NicoGomez4262/control-carga-evse/docs/referencias/F4_autoprogramacion_profesor.jpg

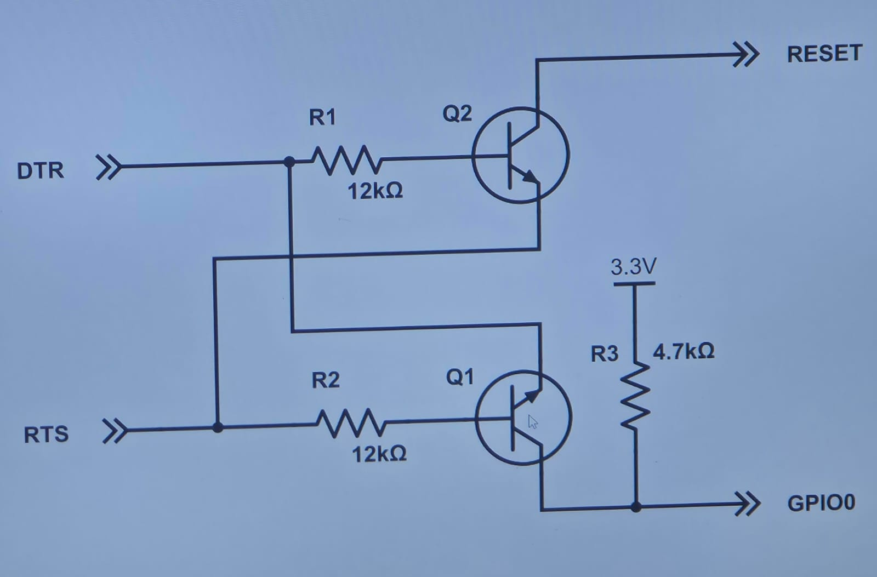
docs/referencias/F4_autoprogramacion_profesor.jpg
