NicoGomez4262/control-carga-evse/docs/revisiones/03_MEDICION_despues_scripts_F4.png

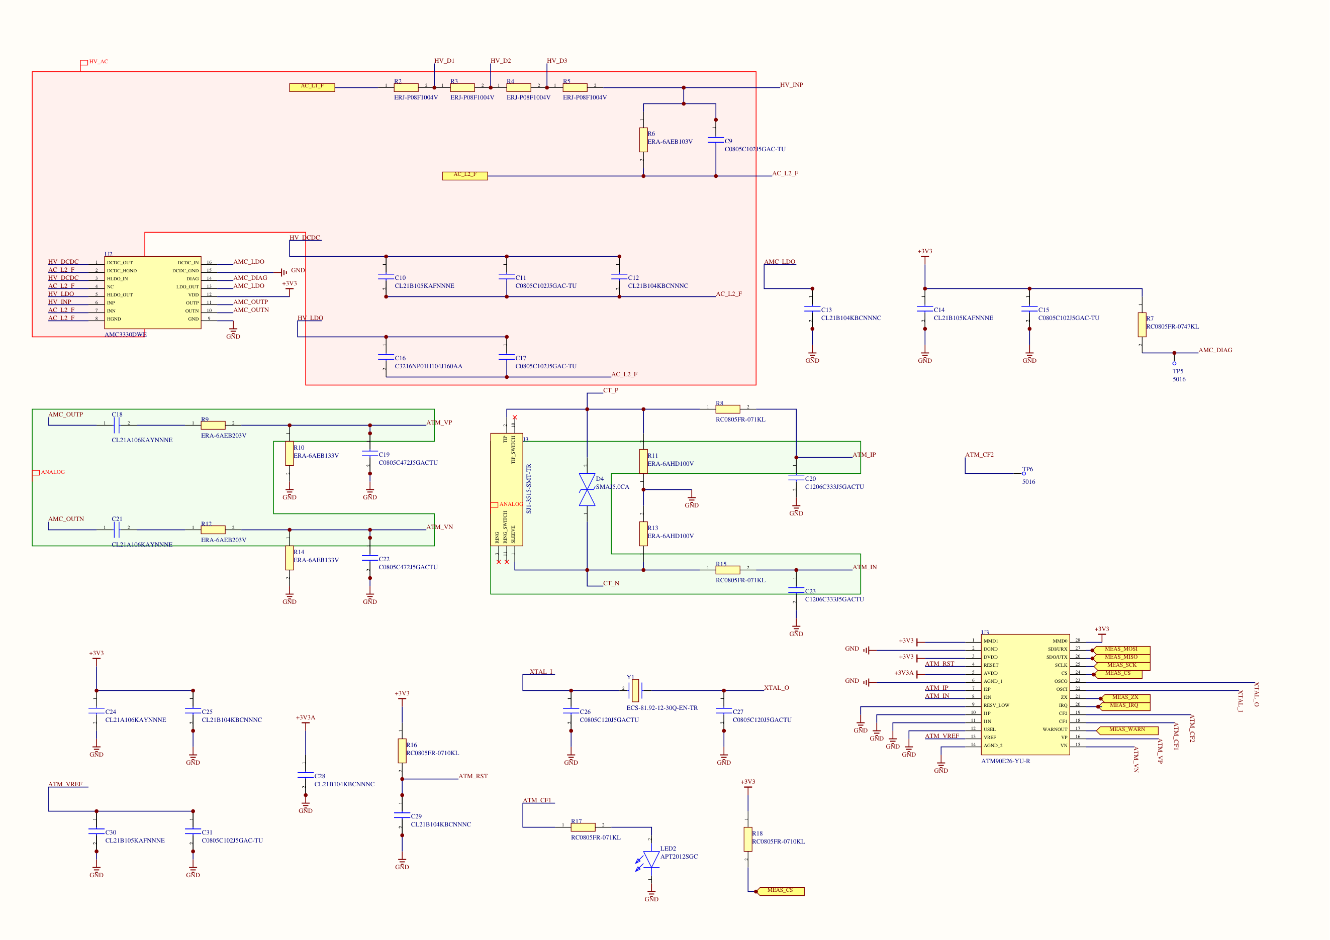
docs/revisiones/03_MEDICION_despues_scripts_F4.png
