NicoGomez4262/control-carga-evse/docs/revisiones/bloque_serigrafia_f9.png

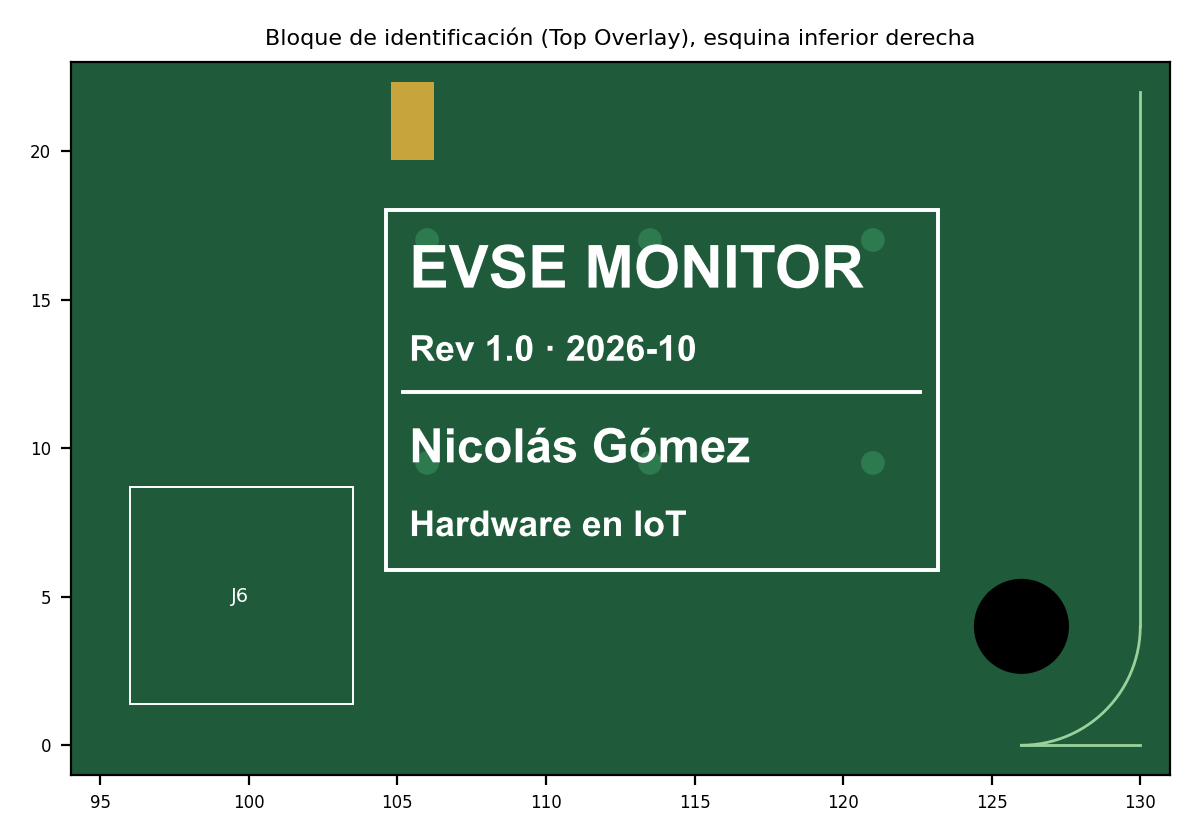
docs/revisiones/bloque_serigrafia_f9.png
