NicoGomez4262/control-carga-evse/docs/revisiones/F8_prerruteo.png

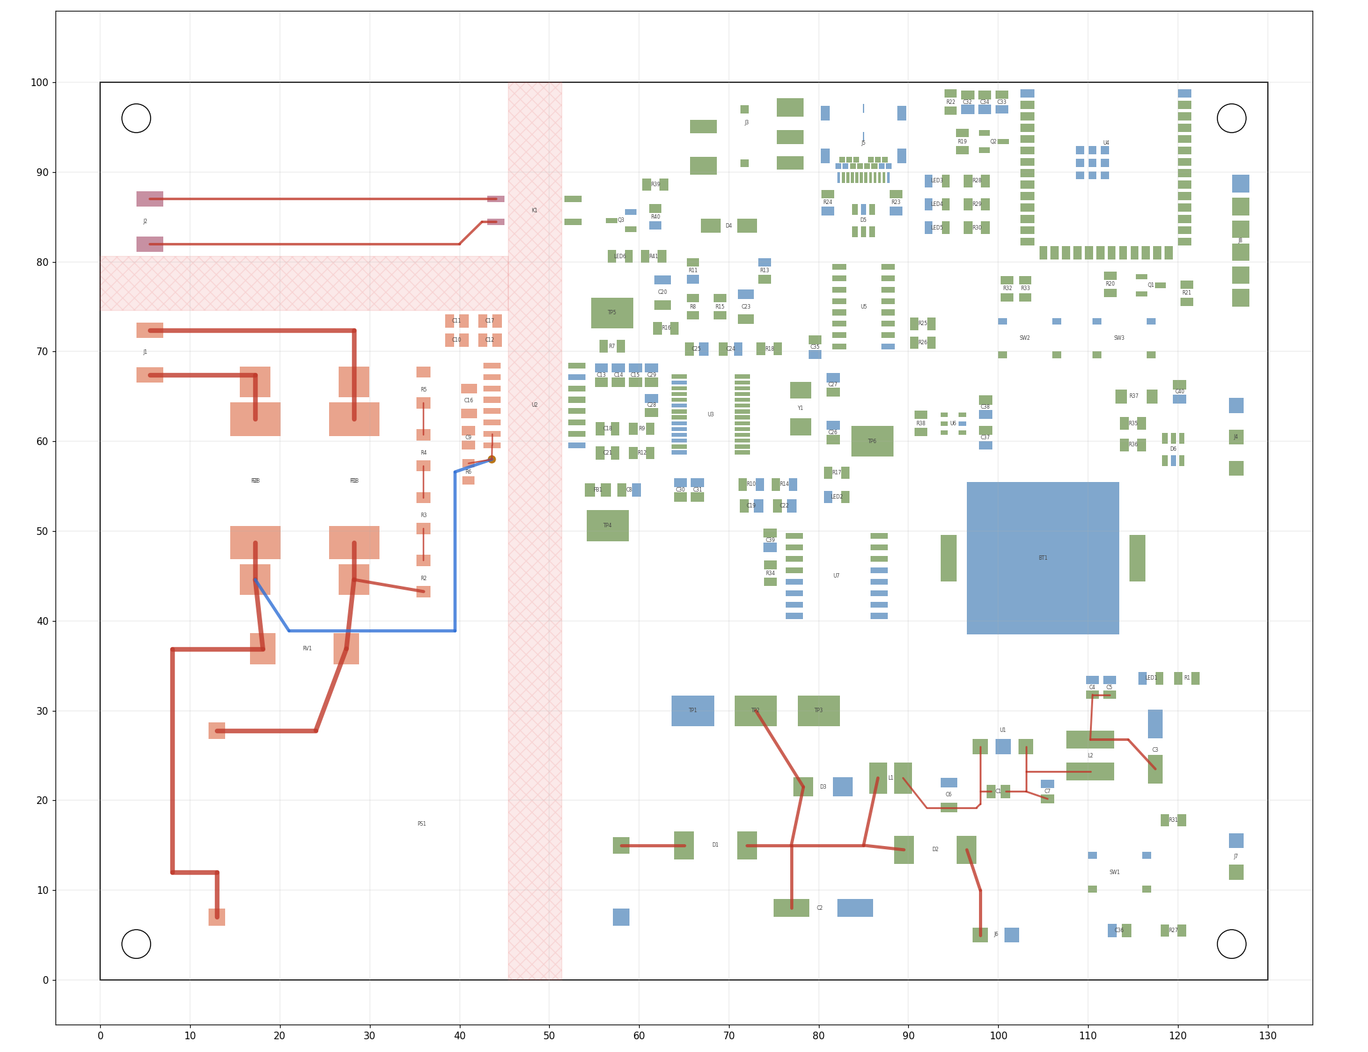
docs/revisiones/F8_prerruteo.png
