NicoGomez4262/control-carga-evse/docs/revisiones/F8_ratsnest.png

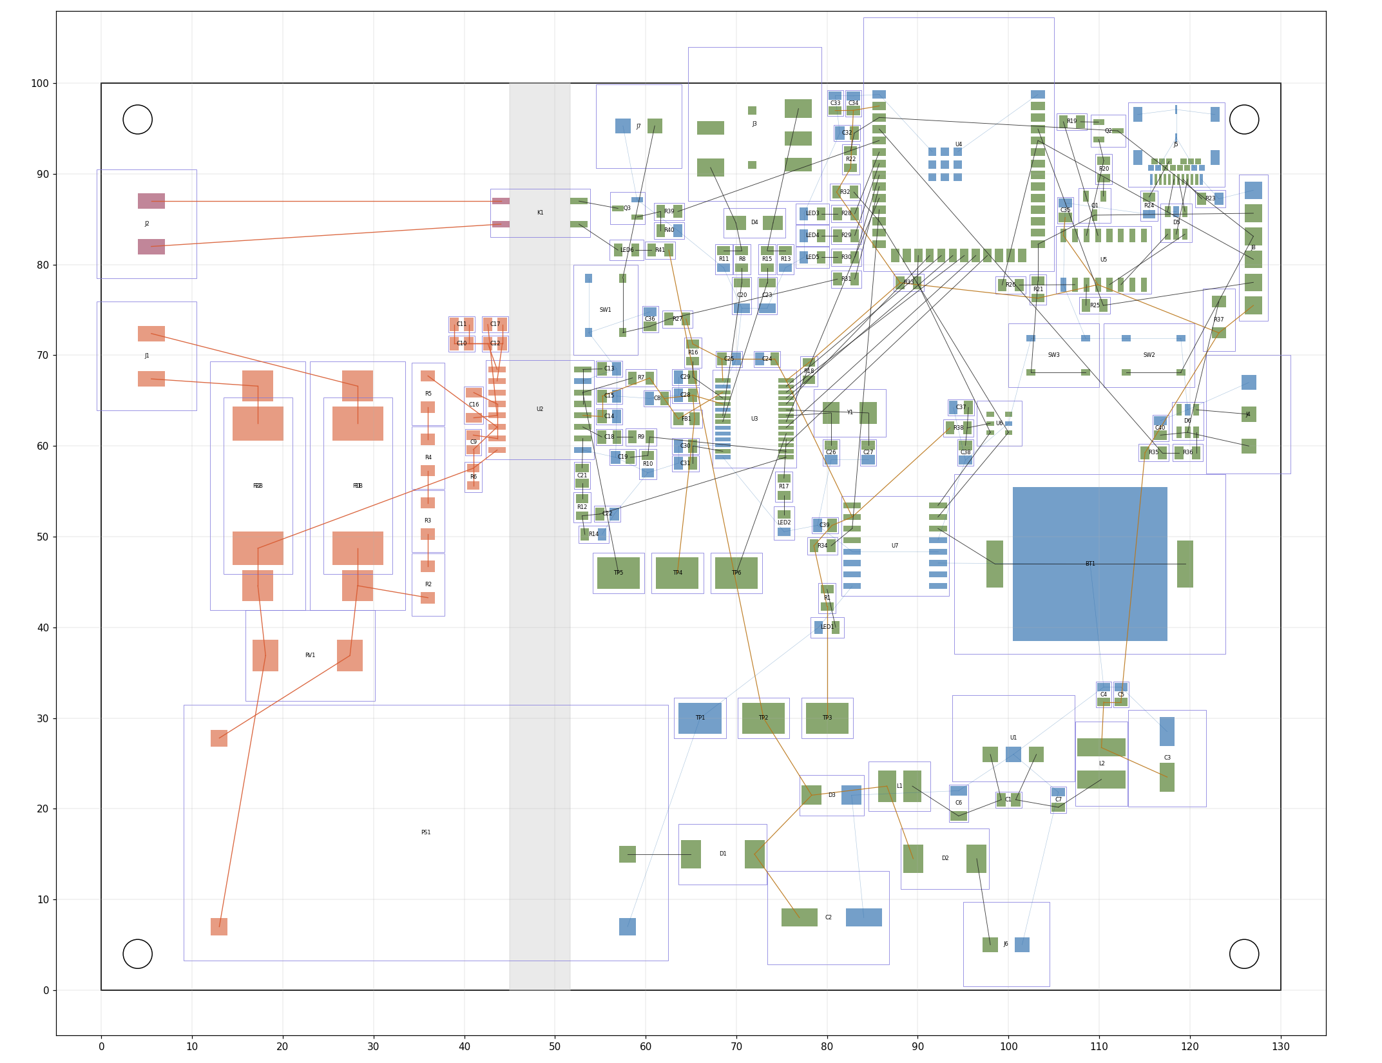
docs/revisiones/F8_ratsnest.png
