NicoGomez4262/control-carga-evse/docs/revisiones/F8_ruteo_completado.png

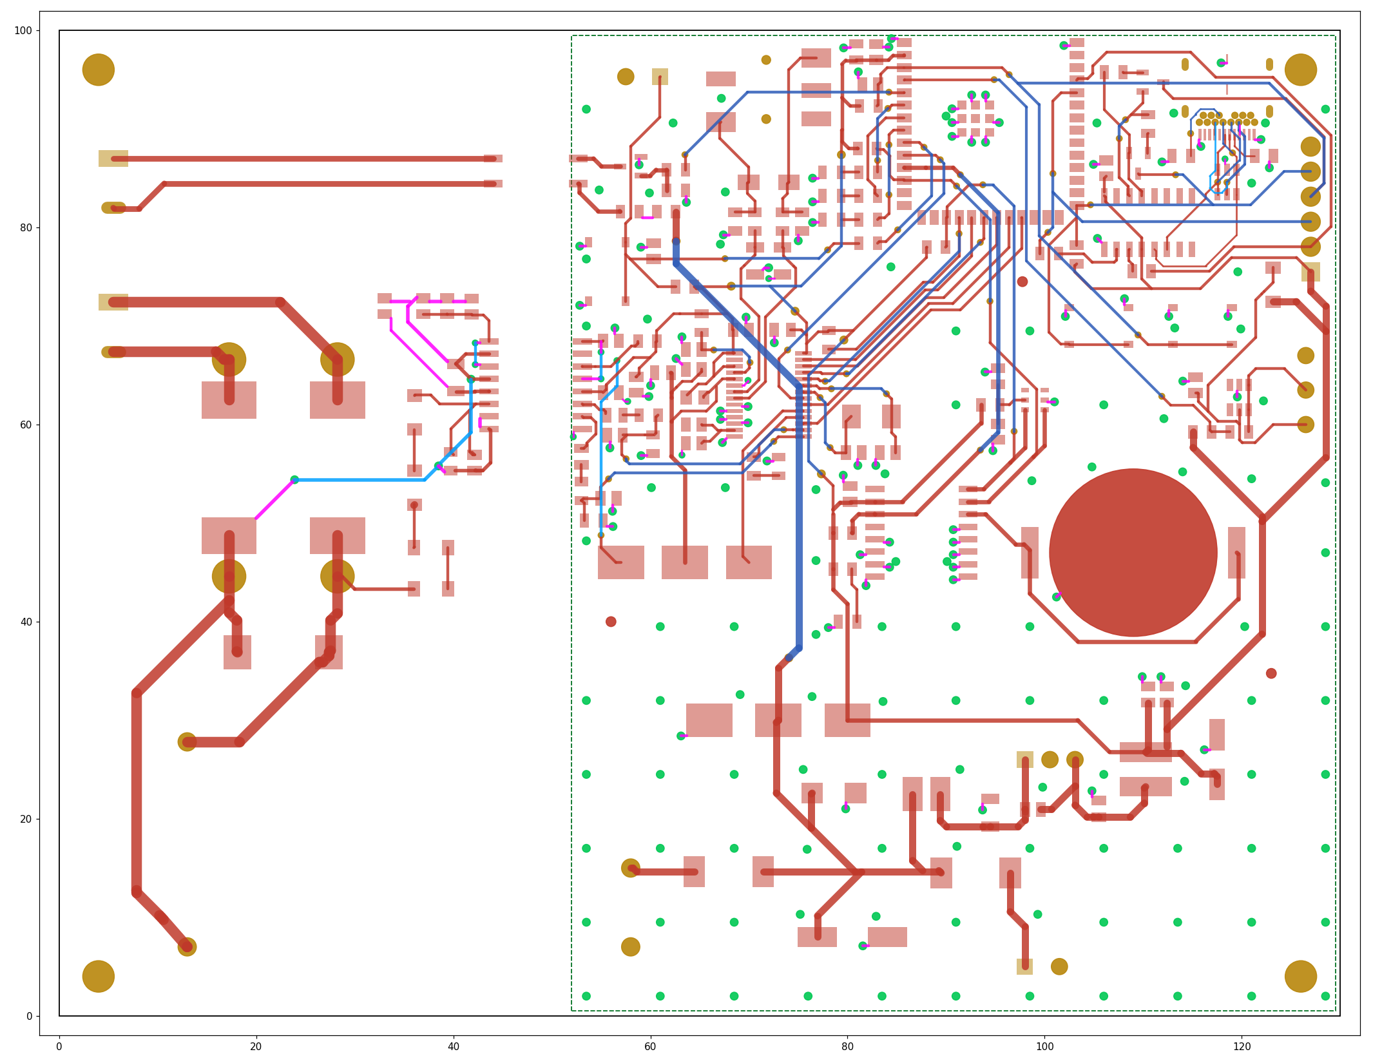
docs/revisiones/F8_ruteo_completado.png
