NicoGomez4262/control-carga-evse/docs/revisiones/F8_ruteo_revision.png

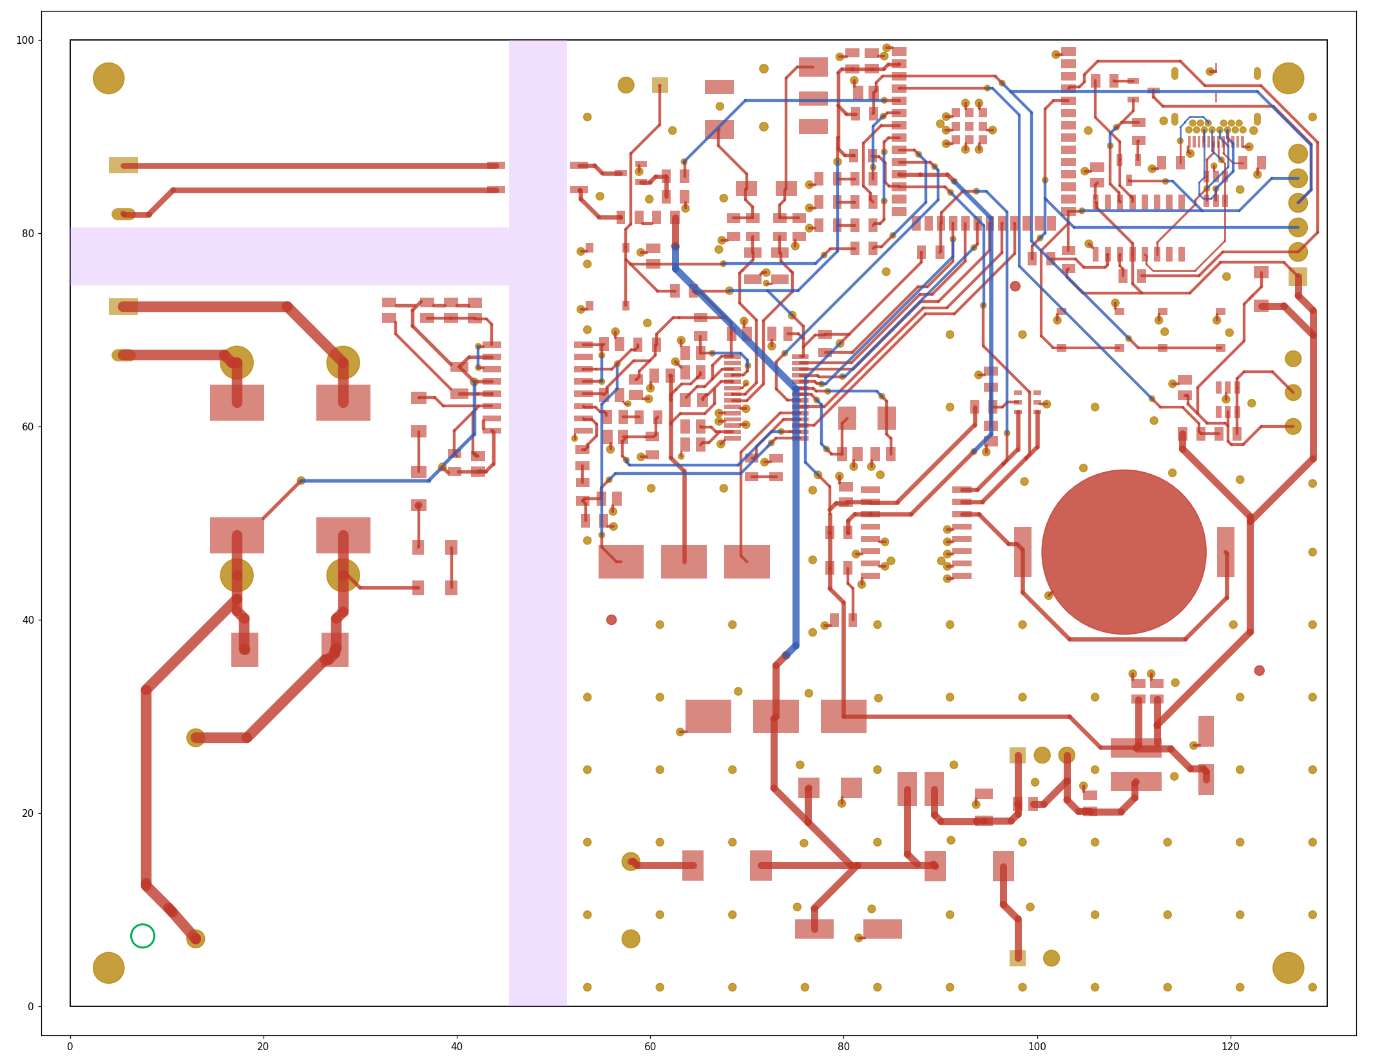
docs/revisiones/F8_ruteo_revision.png
