NicoGomez4262/control-carga-evse/docs/revisiones/F8_serigrafia.png

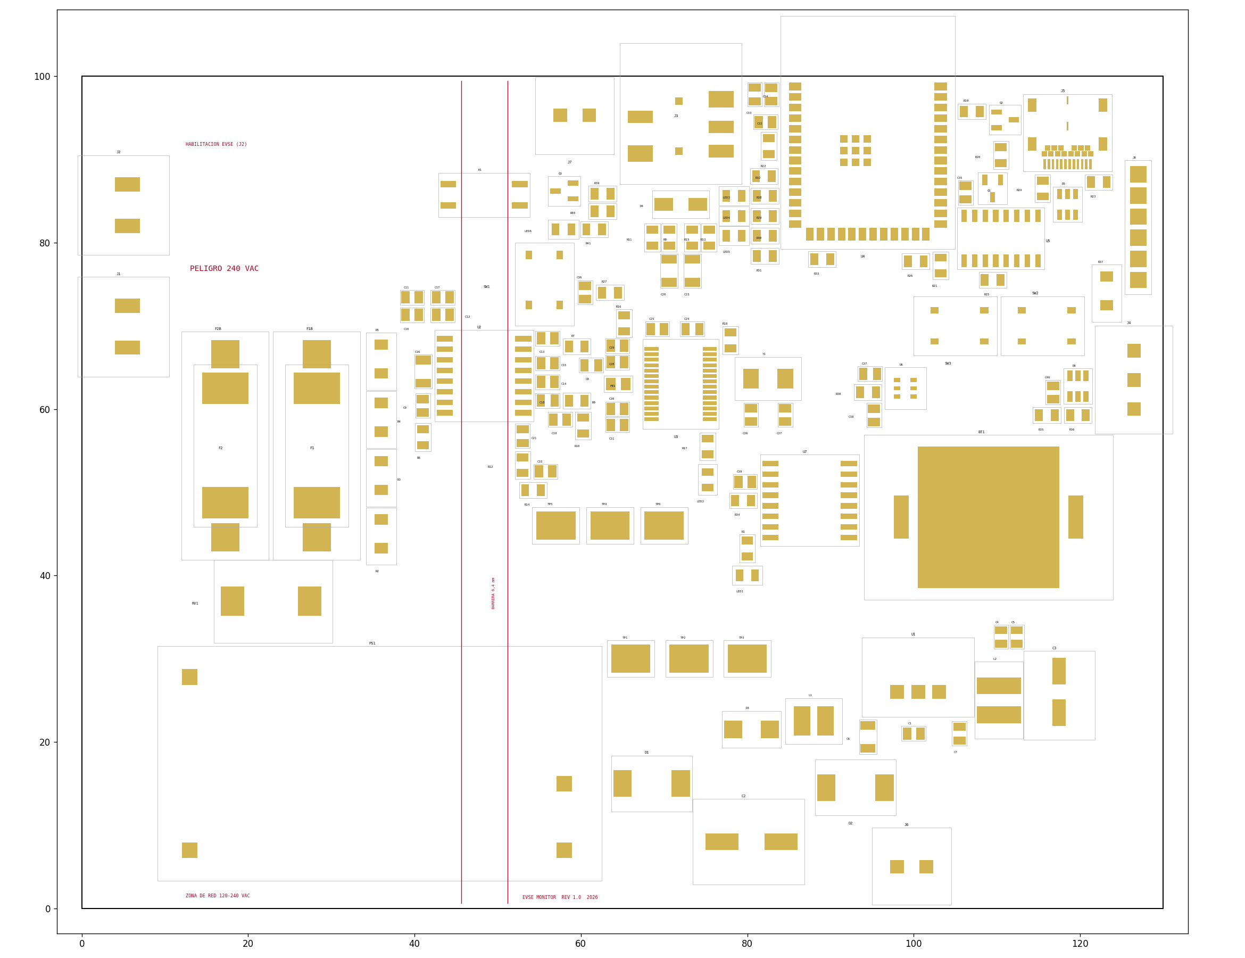
docs/revisiones/F8_serigrafia.png
