NicoGomez4262/control-carga-evse/docs/revisiones/F8_ubicacion.png

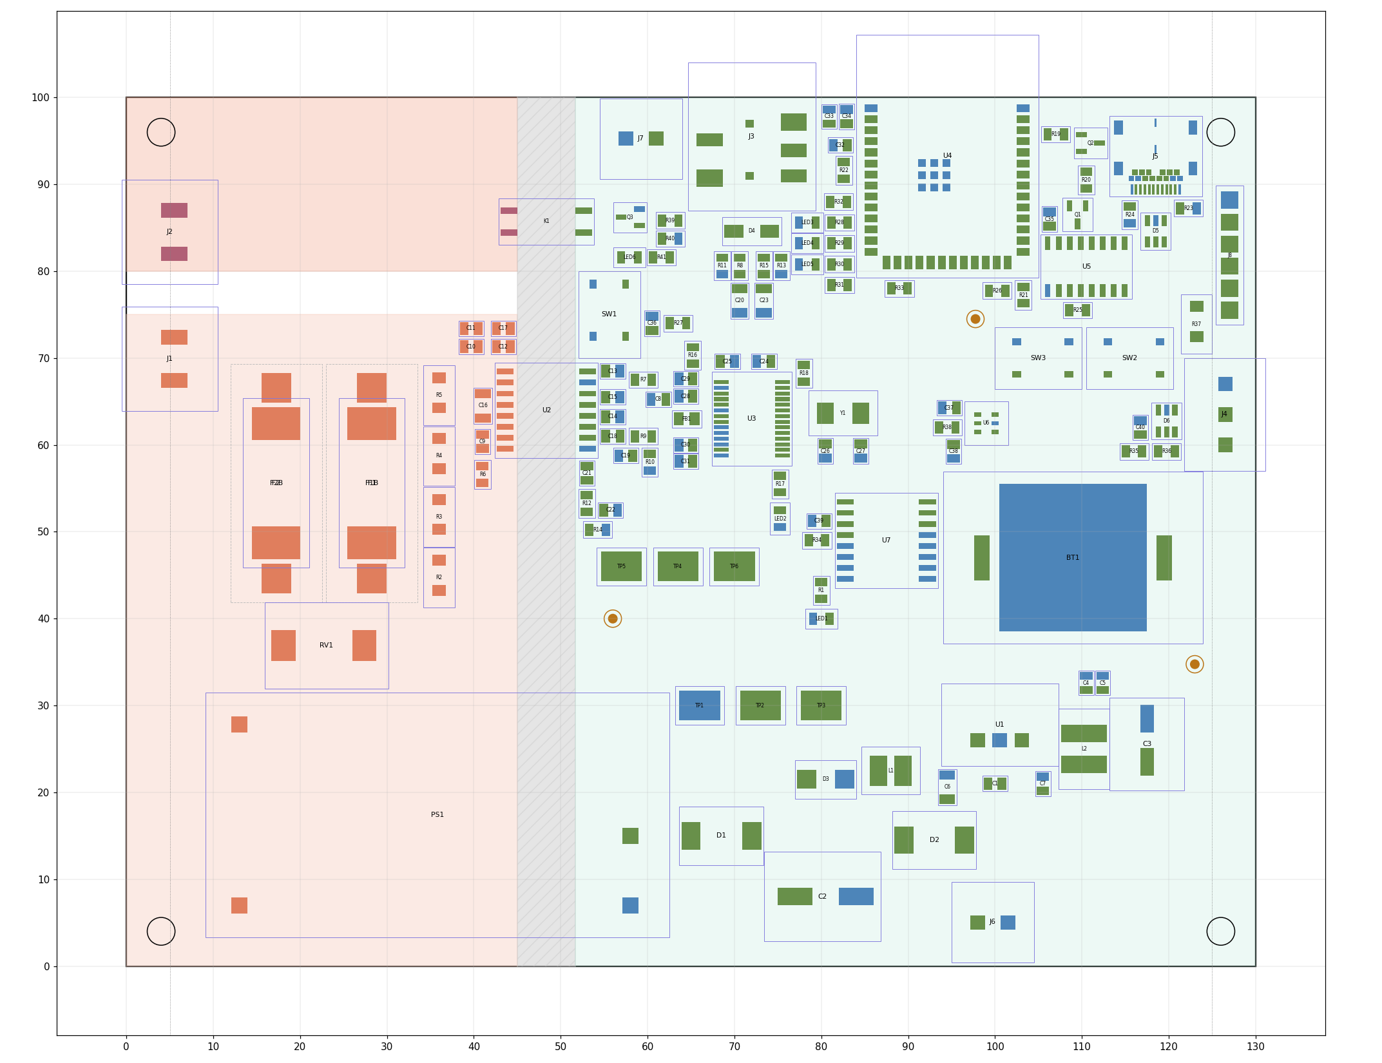
docs/revisiones/F8_ubicacion.png
