NicoGomez4262/control-carga-evse/docs/revisiones/gerber/bottom_cobre.png

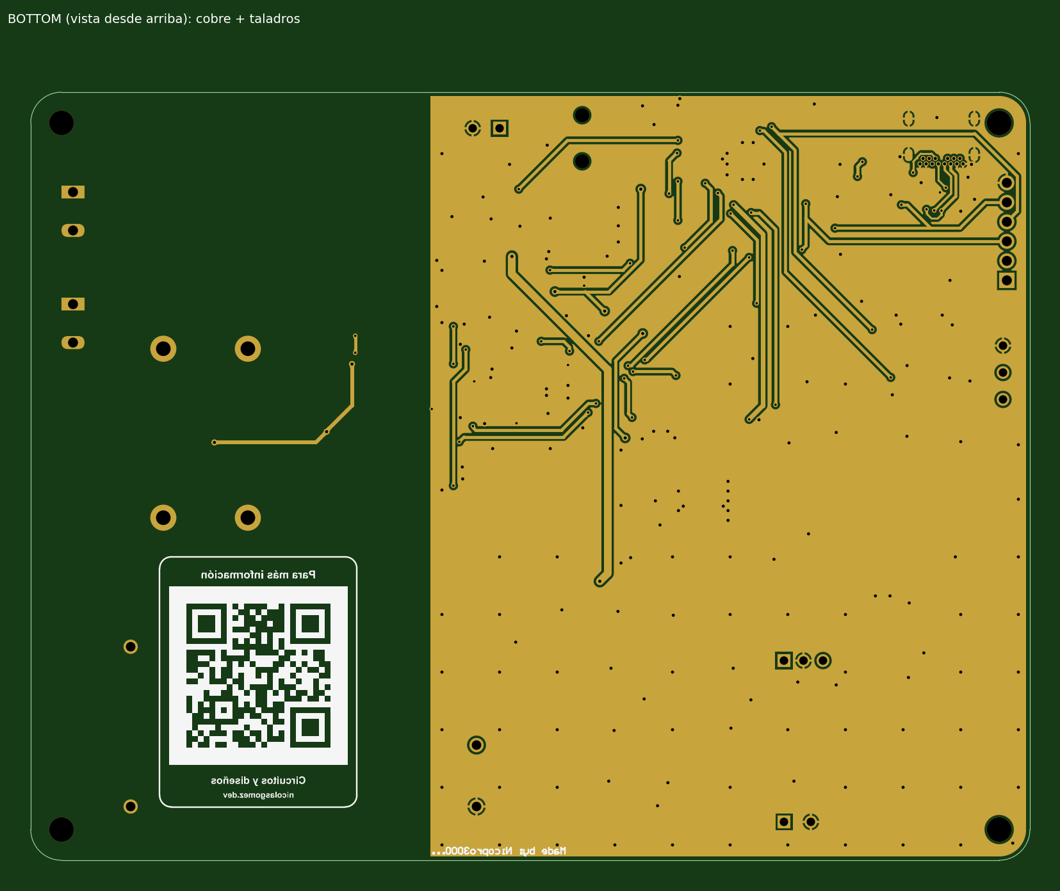
docs/revisiones/gerber/bottom_cobre.png
