NicoGomez4262/control-carga-evse/docs/revisiones/gerber/GBL.png

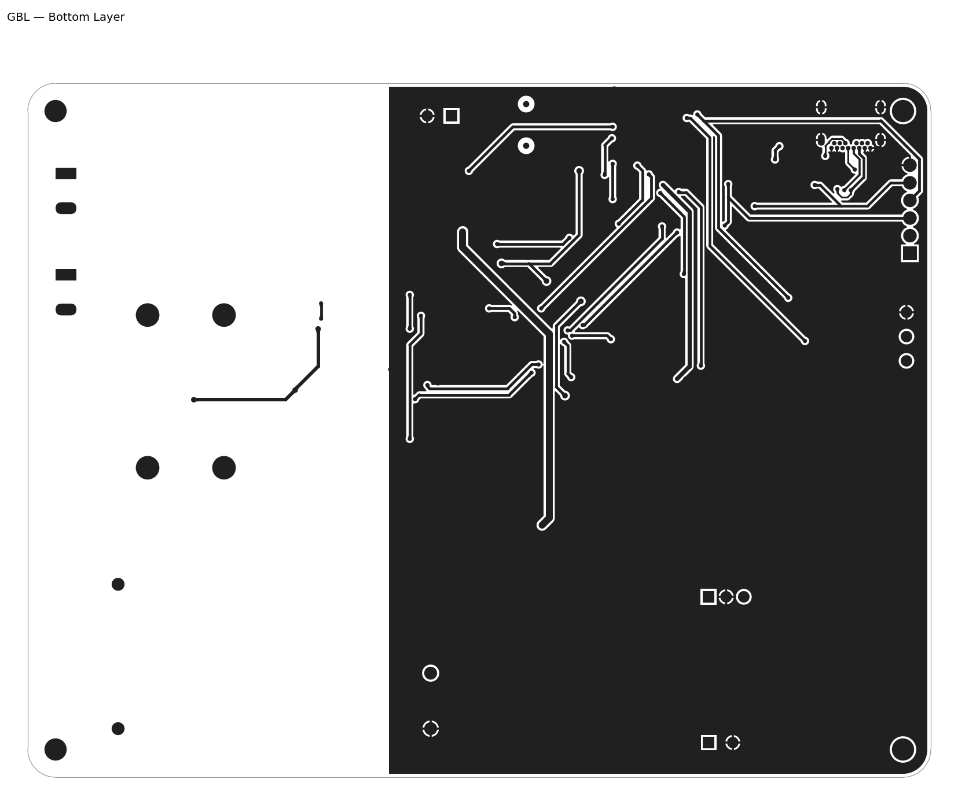
docs/revisiones/gerber/GBL.png
