NicoGomez4262/control-carga-evse/docs/revisiones/gerber/GBO.png

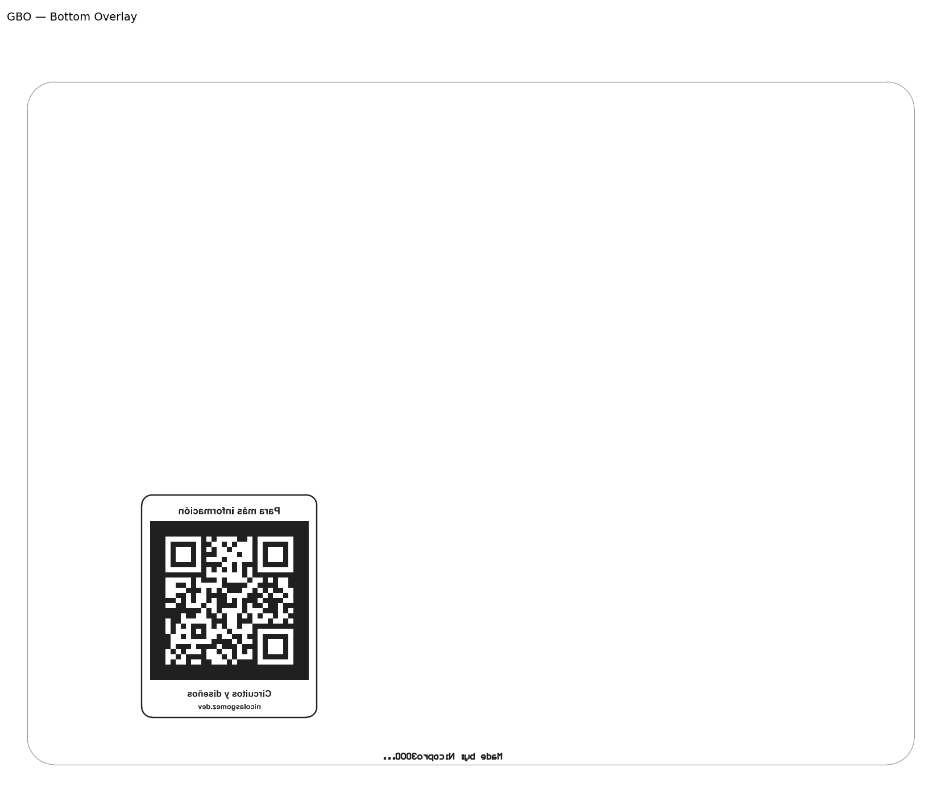
docs/revisiones/gerber/GBO.png
