NicoGomez4262/control-carga-evse/docs/revisiones/gerber/GTL.png

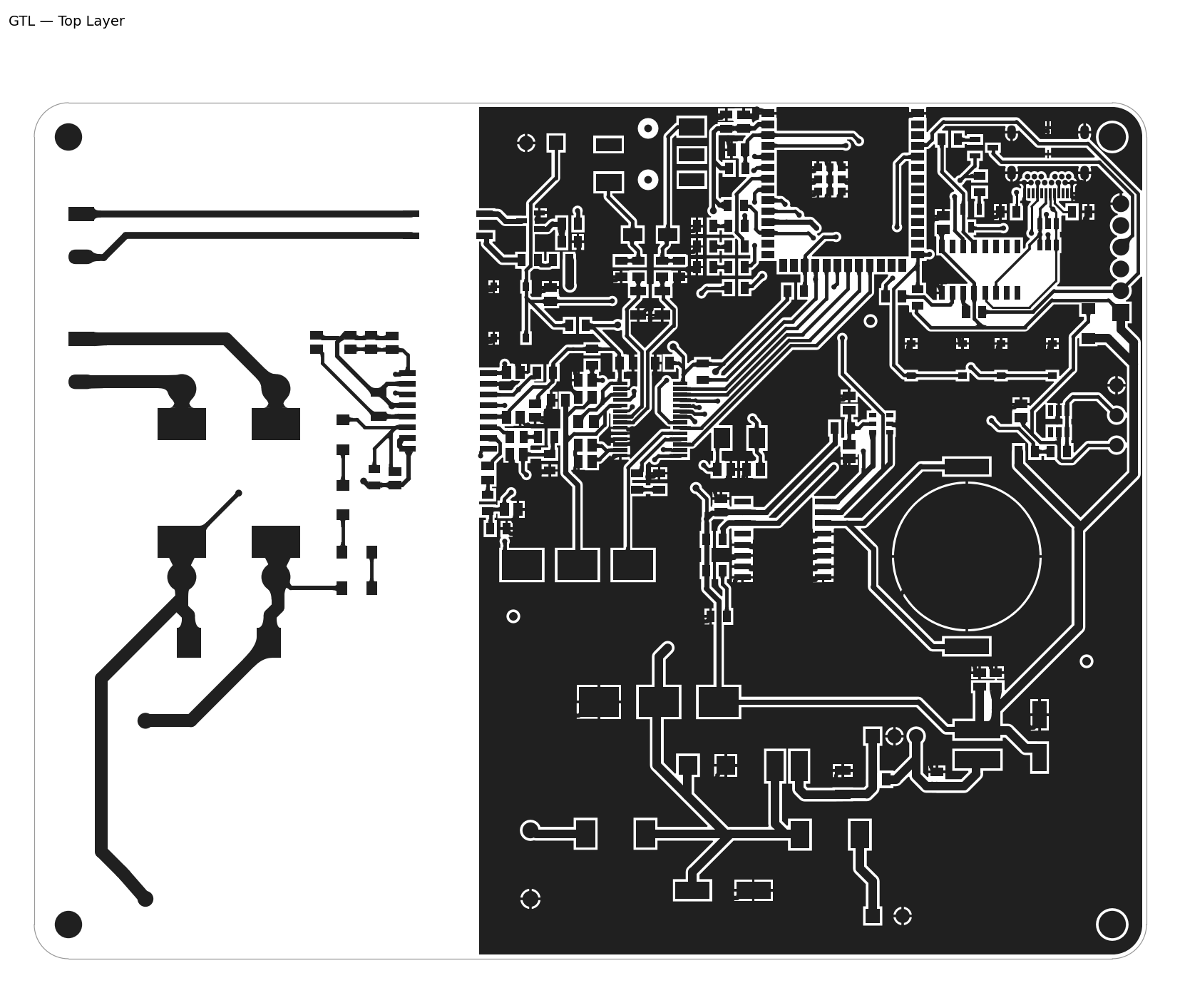
docs/revisiones/gerber/GTL.png
