NicoGomez4262/control-carga-evse/docs/revisiones/gerber/GTO.png

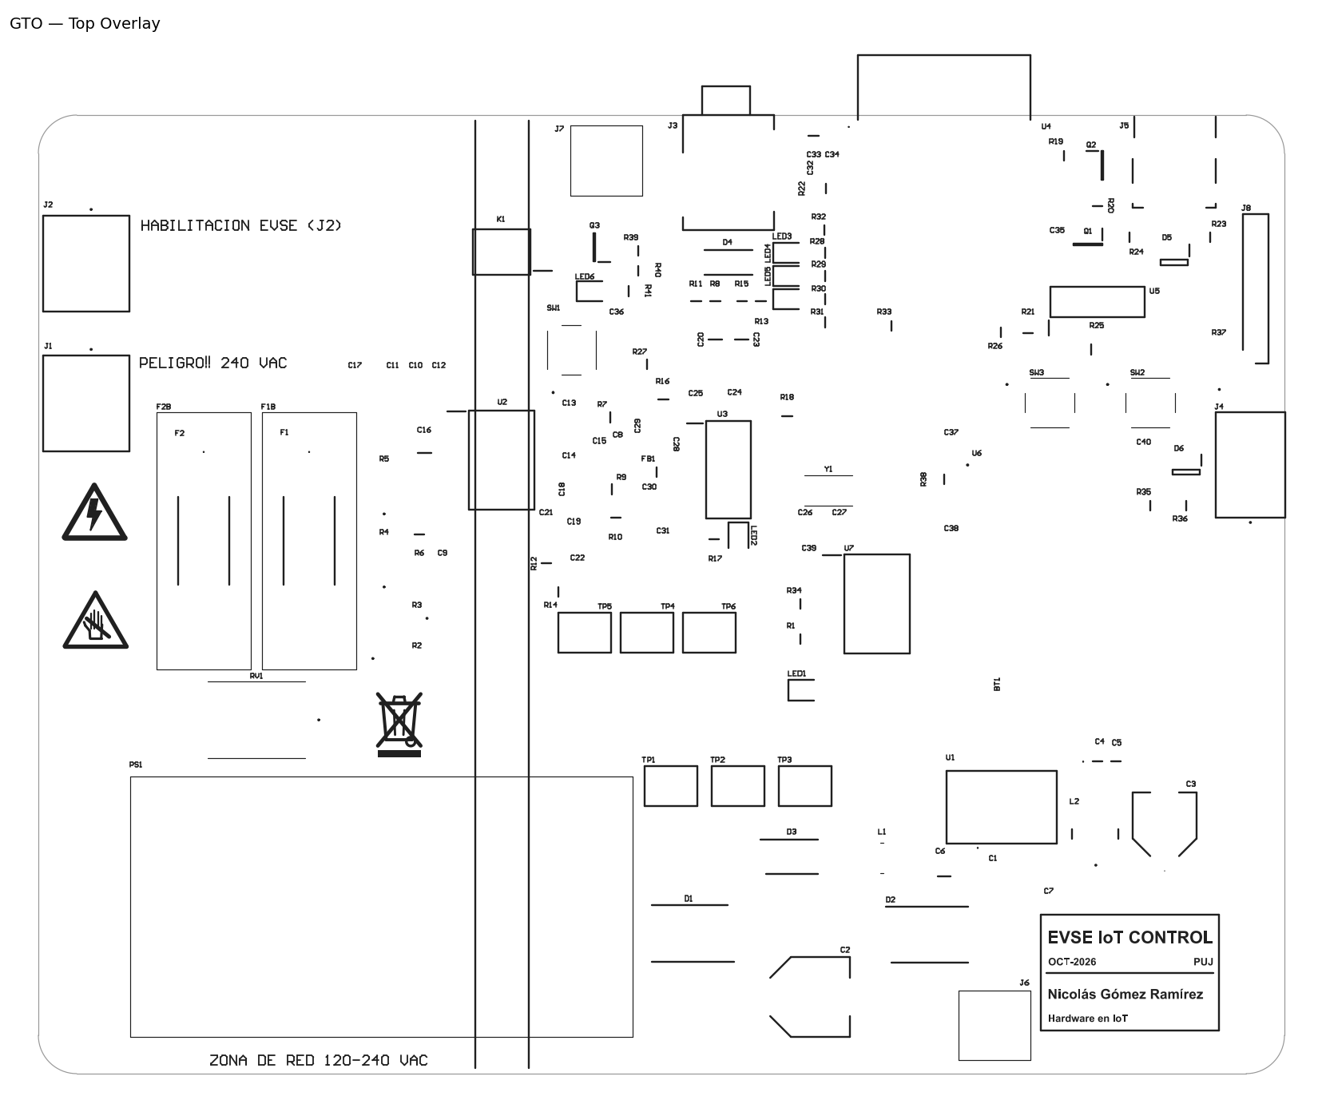
docs/revisiones/gerber/GTO.png
