NicoGomez4262/control-carga-evse/docs/revisiones/gerber/top_cobre_serigrafia.png

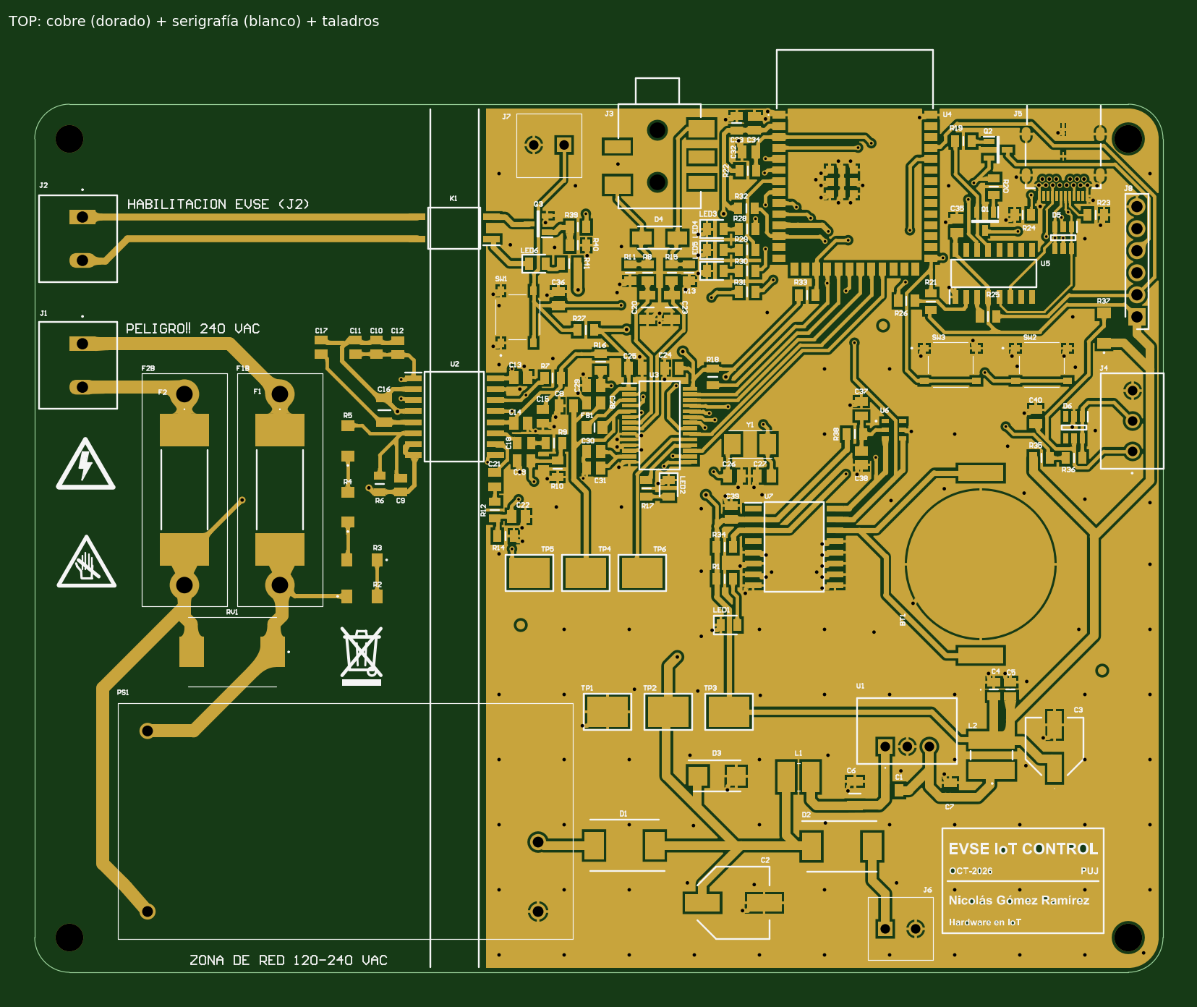
docs/revisiones/gerber/top_cobre_serigrafia.png
