NicoGomez4262/control-carga-evse/docs/revisiones/gerber/top_mascara.png

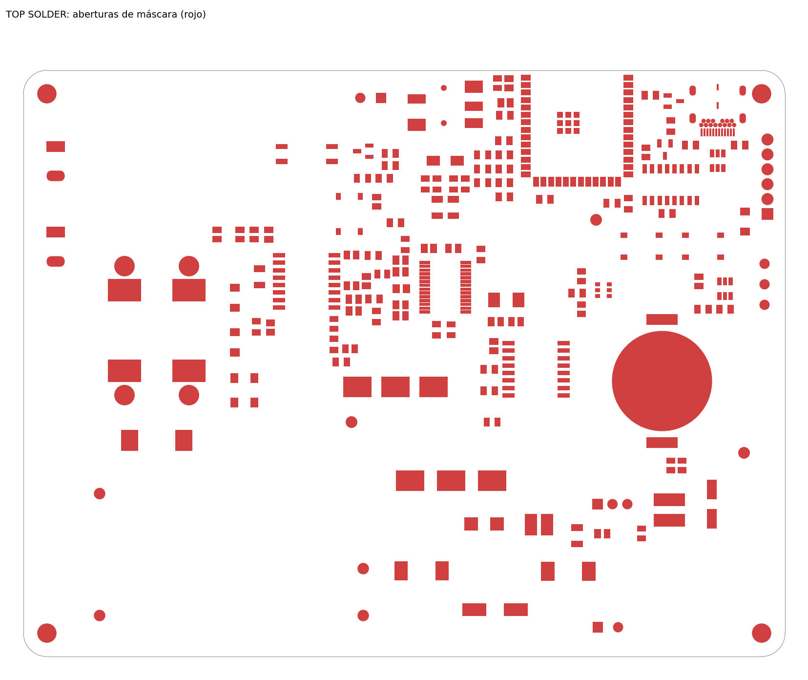
docs/revisiones/gerber/top_mascara.png
