NicoGomez4262/control-carga-evse/docs/revisiones/gerber/top_pasta.png

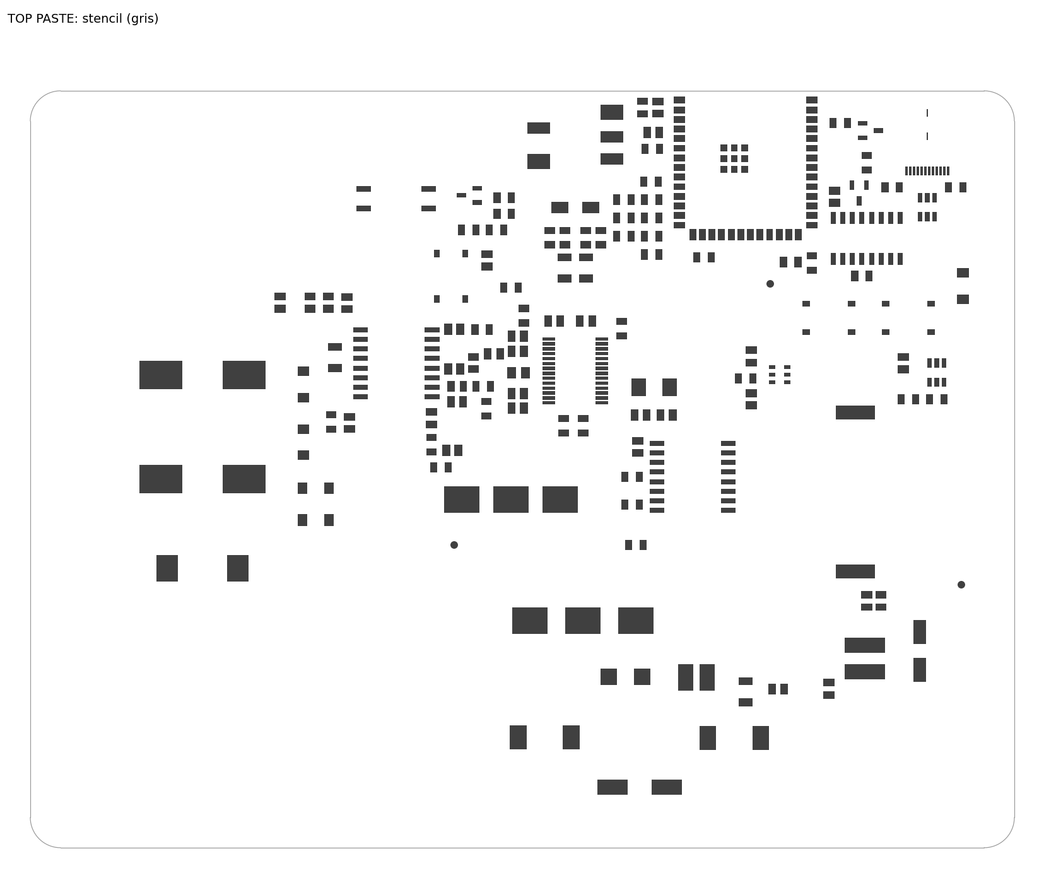
docs/revisiones/gerber/top_pasta.png
