NicoGomez4262/control-carga-evse/docs/revisiones/marcas_f9_bottom.png

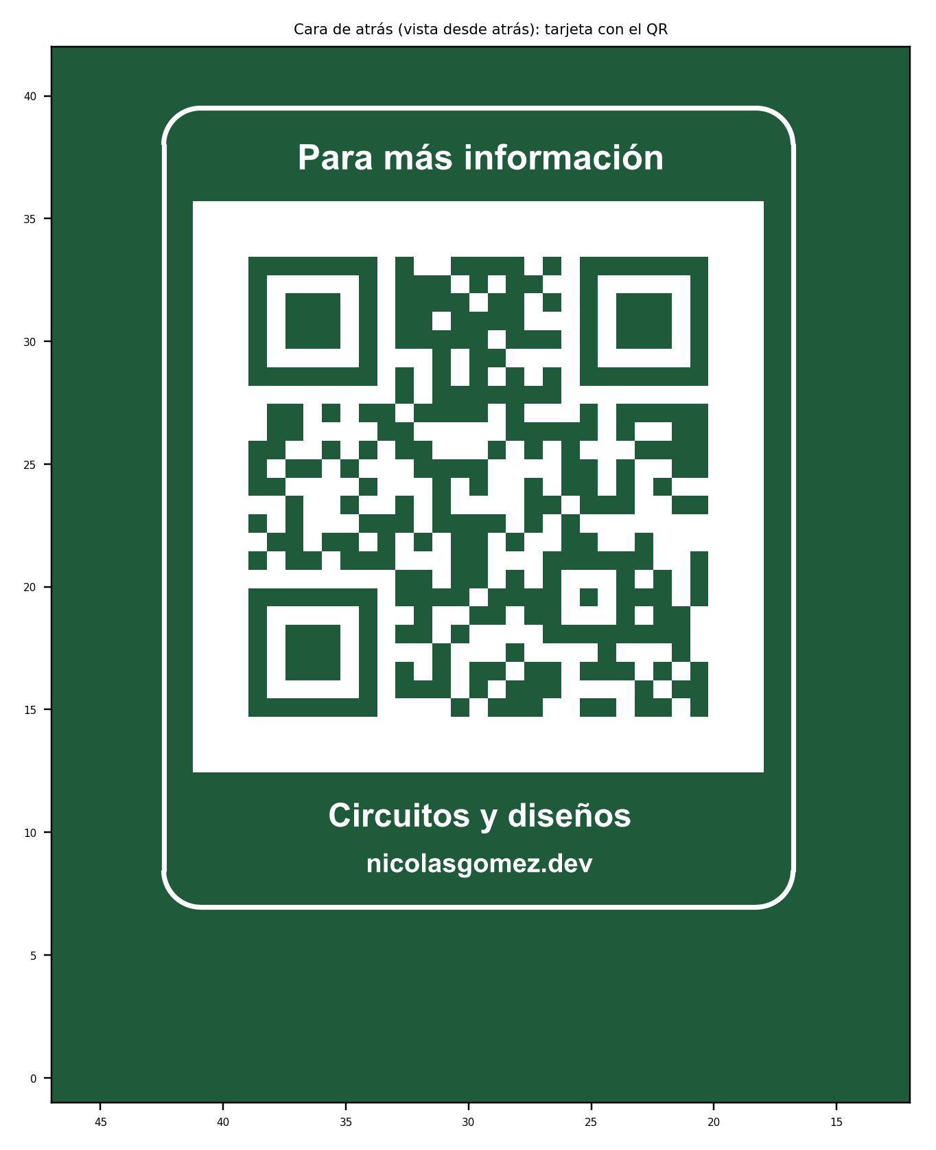
docs/revisiones/marcas_f9_bottom.png
