NicoGomez4262/control-carga-evse/docs/revisiones/marcas_f9_top.png

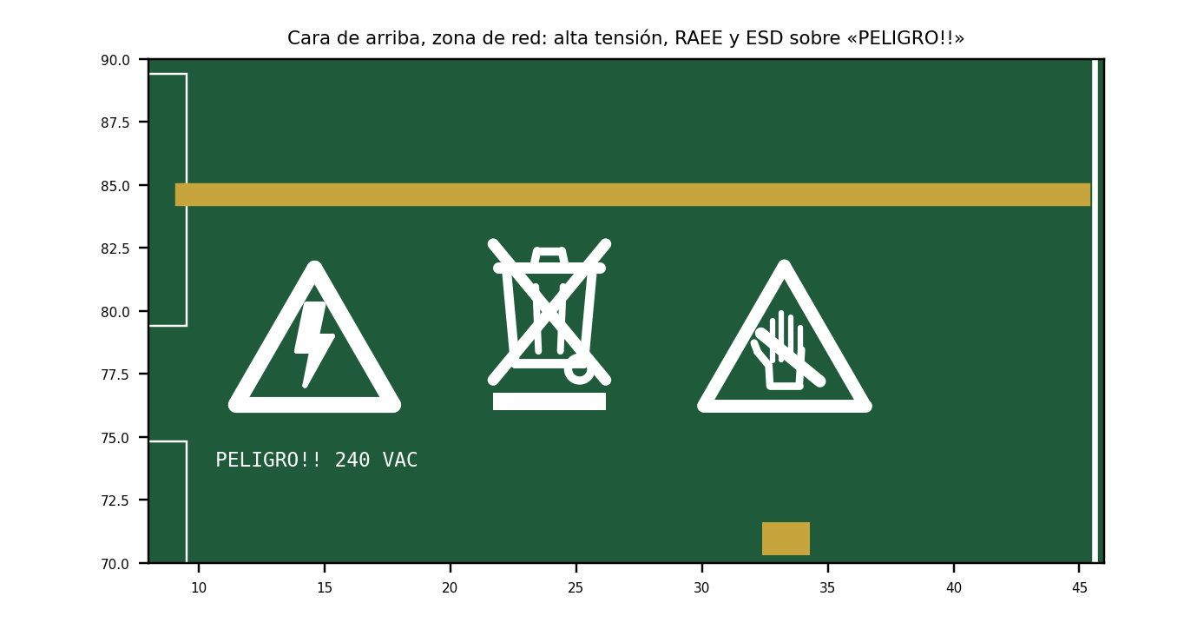
docs/revisiones/marcas_f9_top.png
