NicoGomez4262/control-carga-evse/docs/fabricacion/BOM_JLC.csv

Comment | Designator | Footprint | JLCPCB Part #
BAT-HLD-001 | BT1 | BATHLD001 | C7501066
C0805C102J5GACTU | C1,C9,C11,C15,C17,C31 | CAPC2012X88N | C2167084
EEE-FK1V101P | C2 | EEHZT1E331UP | C128462
EEE-FK1C101P | C3 | EEE1AA101SP | C128532
CL21A226MAQNNNE | C4,C5,C33 | CAPC2012X140N | C45783
CL31B106KBHNNNE | C6 | CAPC3216X180N | C89632
CL21A106KAYNNNE | C7,C8,C18,C21,C24,C37 | CAPC2012X145N | C15850
CL21B105KBFNNNE | C10,C14,C30,C32 | CAPC2012X88N | C28323
CC0805KRX7R9BB104 | C12,C13,C25,C28,C29,C34,C35,C36,C38,C39,C40 | CAPC2012X88N | C49678
GRM31C5C1H104JA01L | C16 | CAPC3216X180N | C97946
C0805C472J5GACTU | C19,C22 | CAPC2012X88N | C2170898
GRM3195C1H333JA01D | C20,C23 | CAPC3216X180N | C97930
C0805C120J5GACTU | C26,C27 | CAPC2012X88N | C2168859
SS34-E3/57T | D1,D2 | DIOM7959X262N | C13354
SMBJ15A | D3 | DIOM5436X244N | C83846
SMAJ5.0CA | D4 | DIONM5026X229N | C83324
USBLC6-2SC6 | D5,D6 | SOT95P280X145-6N | C7519
3403.0274.11 | F1,F2 | 3403027423 | C6384960
BLM21PG221SN1D | FB1 | BEADC2012X105N | C85840
XY301V-A-5.0-2P | J1,J2 | TB001-500-02BE | C557651
SJ1-3515-SMT-TR | J3 | SJ13515SMTTR | C22359767
1751251 | J4 | 1751251 | C91152
632723300011 | J5 | 632723300011 | C2830802
1751248 | J6,J7 | 1751248 | C89122
61300611121 | J8 | HDRV6W79P0X254_1X6_1524X254X894P | C5444523
LQH43NH120J03L | L1 | RLS126 | C3224514
SRR4028-2R2Y | L2 | SRR4028 | C2041777
APT2012SGC | LED1,LED2,LED3,LED4 | LEDC2012X85N | C5353439
APT2012SURCK | LED5 | LEDC2012X85N | C5875730
KT-0805Y | LED6 | LEDC2012X85N | C2296
IRM-20-12 | PS1 | IRM2012 | C5278499
MMBT3904 | Q1,Q2 | SOT96P237X111-3N | C20526
AO3400A | Q3 | SOT96P237X111-3N | C20917
0805W8F1001T5E | R1,R8,R15,R17,R25,R26,R28,R29,R30,R31,R39,R41 | RESC2012X60N | C17513
ERJ-P08F1004V | R2,R3,R4,R5 | ERJP08_(1206) | C41369755
ERA-6AEB103V | R6 | RESC2012X60N | C191101
0805W8F4702T5E | R7 | RESC2012X60N | C17713
ERA-6AEB203V | R9,R12 | RESC2012X60N | C473304
ERA-6AEB133V | R10,R14 | RESC2012X60N | C445658
RT0805BRD0710RL | R11,R13 | RESC2012X60N | C865142
0805W8F1002T5E | R16,R18,R22,R27,R34,R40 | RESC2012X60N | C17414
0805W8F1202T5E | R19,R20 | RESC2012X60N | C17444
0805W8F4701T5E | R21,R32,R33,R35 | RESC2012X60N | C17673
0805W8F5101T5E | R23,R24 | RESC2012X60N | C27834
0805W8F1000T5E | R36 | RESC2012X60N | C17408
RC1206FR-0768RL | R37 | ERJP08_(1206) | C137238
0805W8F3300T5E | R38 | RESC2012X60N | C17630
RL4032P471KJ | RV1 | CU4032 | C2935514
TS-1187A-B-A-B | SW1 | TS1187ABAB | C318884
RH-5016 | TP1,TP2,TP3,TP4,TP5,TP6 | KEYSTONE-5016_V | C5199799
AMC3330DWER | U2 | SOIC127P1030X265-16N | C2999368
ATM90E26-YU-R | U3 | SOP65P778X199-28N | C616398
ESP32-S3-WROOM-1-N16R2 | U4 | ESP32S3WROOM1N16R2 | C2913205
CH340C | U5 | SOIC127P600X175-16N | C84681
AHT20 | U6 | AHT20 | C2757850
DS3231SN#T&R | U7 | SOIC127P1030X265-16N | C9866
ECS-81.92-12-30Q-EN-TR | Y1 | ECS81921230QENTR | C2450755
AQY214EHAX | K1 | SOP254P962X315-4N | C371971
