NicoGomez4262/control-carga-evse/docs/revisiones/F1_TOP.pdf

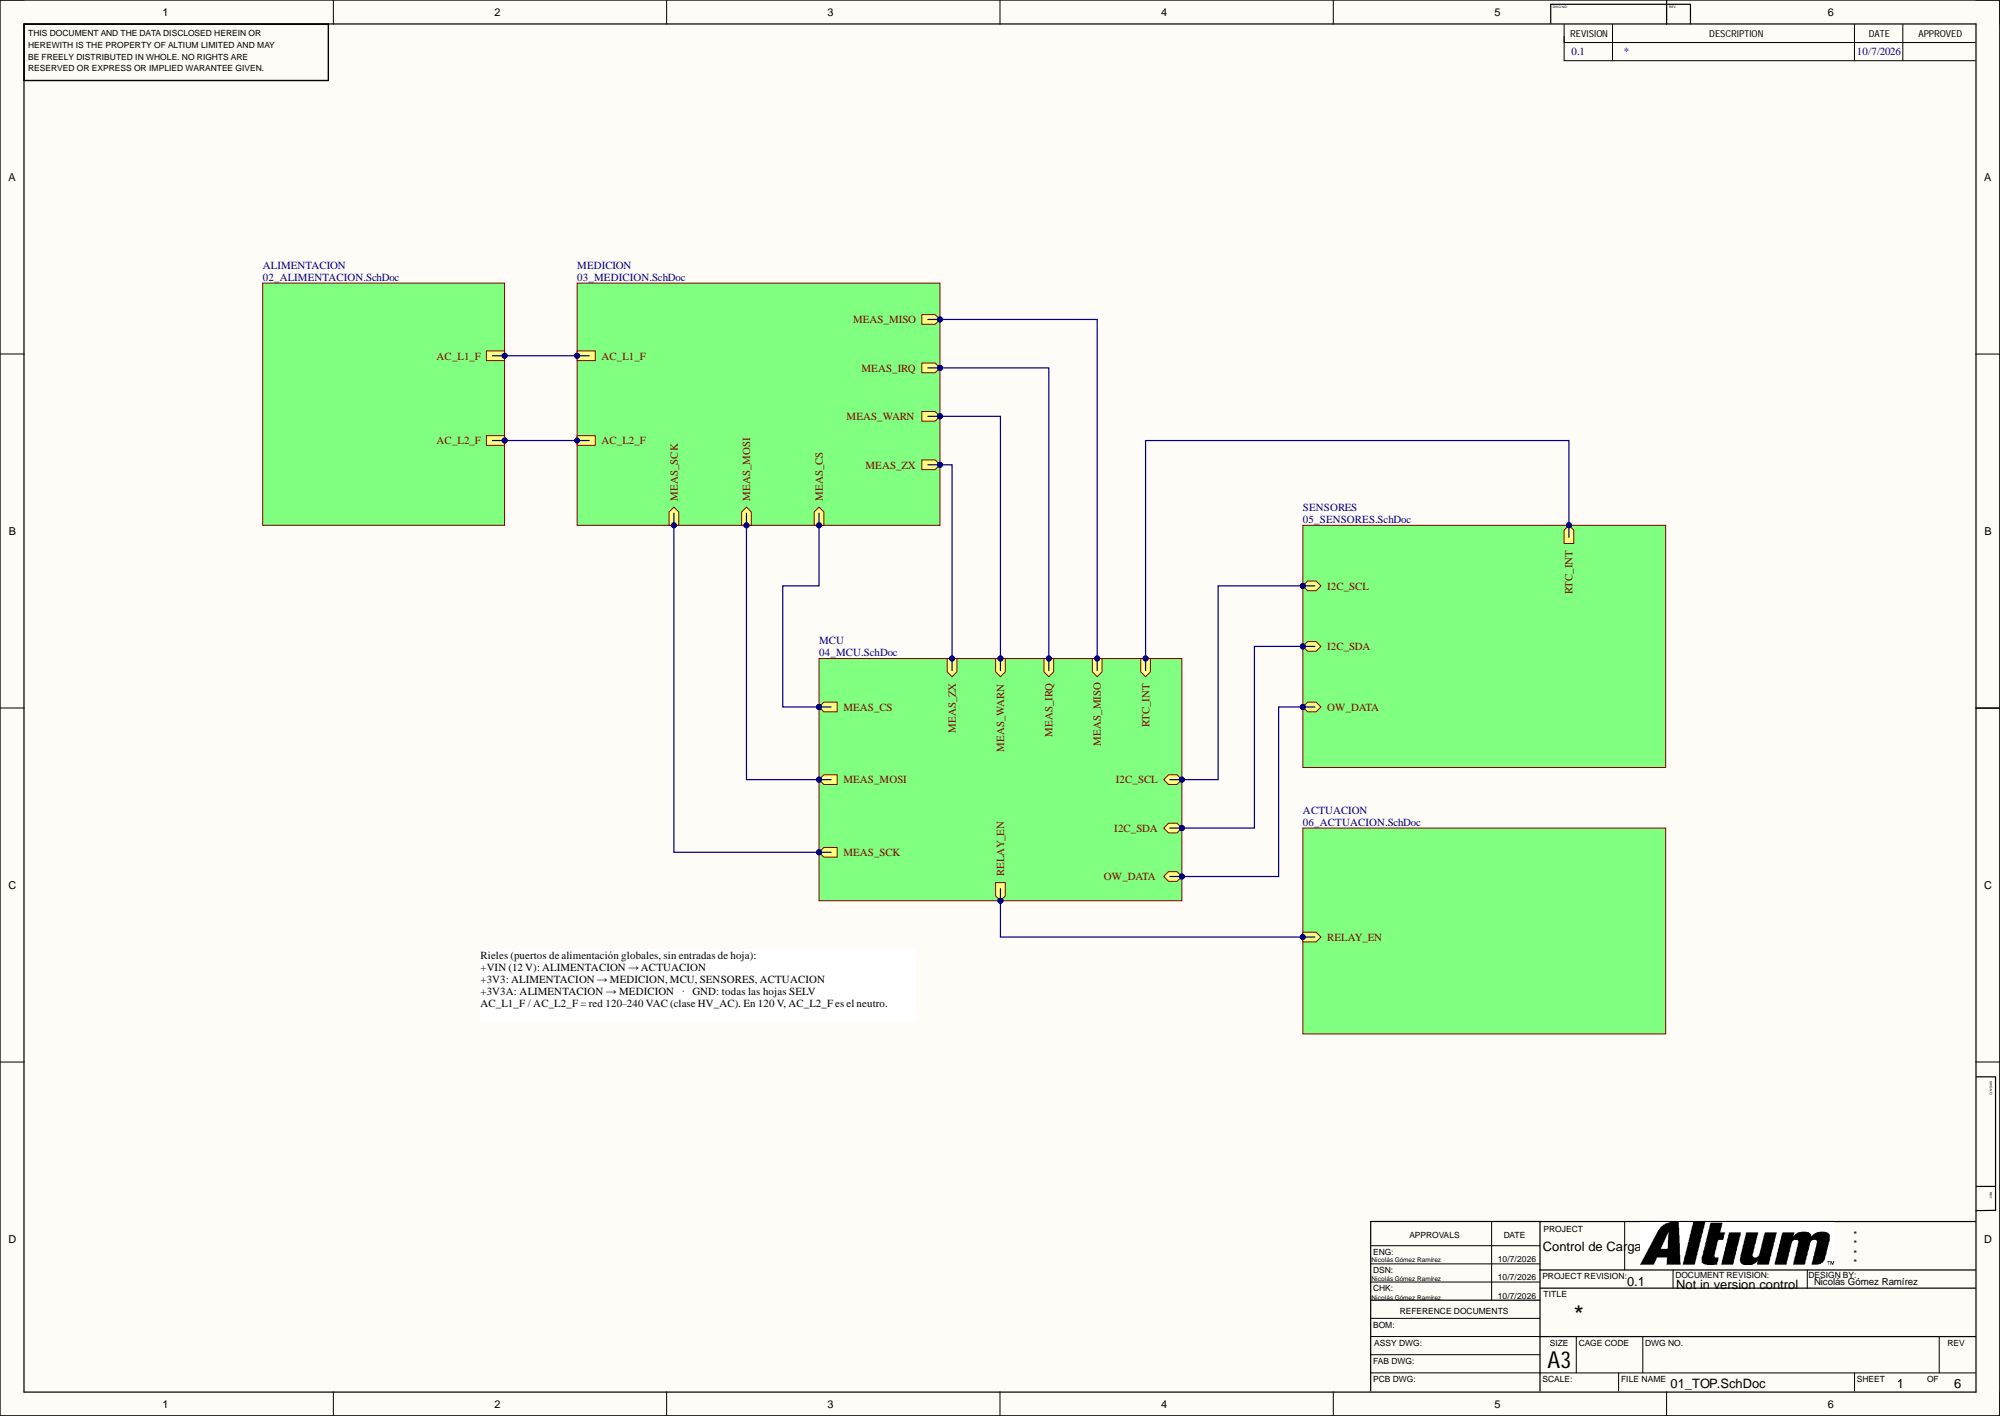
[picture p30: page 1]

DWG NO: | REV:

THIS DOCUMENT AND THE DATA DISCLOSED HEREIN OR HEREWITH IS THE PROPERTY OF ALTIUM LIMITED AND MAY BE FREELY DISTRIBUTED IN WHOLE. NO RIGHTS ARE RESERVED OR EXPRESS OR IMPLIED WARANTEE GIVEN. 02_ALIMENTACION.SchDoc | MEDICION 03_MEDICION.SchDoc | REVISION | DESCRIPTION | DATE | APPROVED

Rieles (puertos de alimentación globales, sin entradas de hoja):
+VIN (12 V): ALIMENTACION → ACTUACION
+3V3: ALIMENTACION → MEDICION, MCU, SENSORES, ACTUACION
+3V3A: ALIMENTACION → MEDICION · GND: todas las hojas SELV
AC_L1_F / AC_L2_F = red 120–240 VAC (clase HV_AC). En 120 V, AC_L2_F es el neutro.

DATE | PROJECT Control de Carga IoT.PrjPcb | * * APPROVALS * *

ENG: Nicolás Gómez Ramírez | 10/7/2026

DSN: Nicolás Gómez Ramírez | 10/7/2026

CHK: Nicolás Gómez Ramírez | 10/7/2026

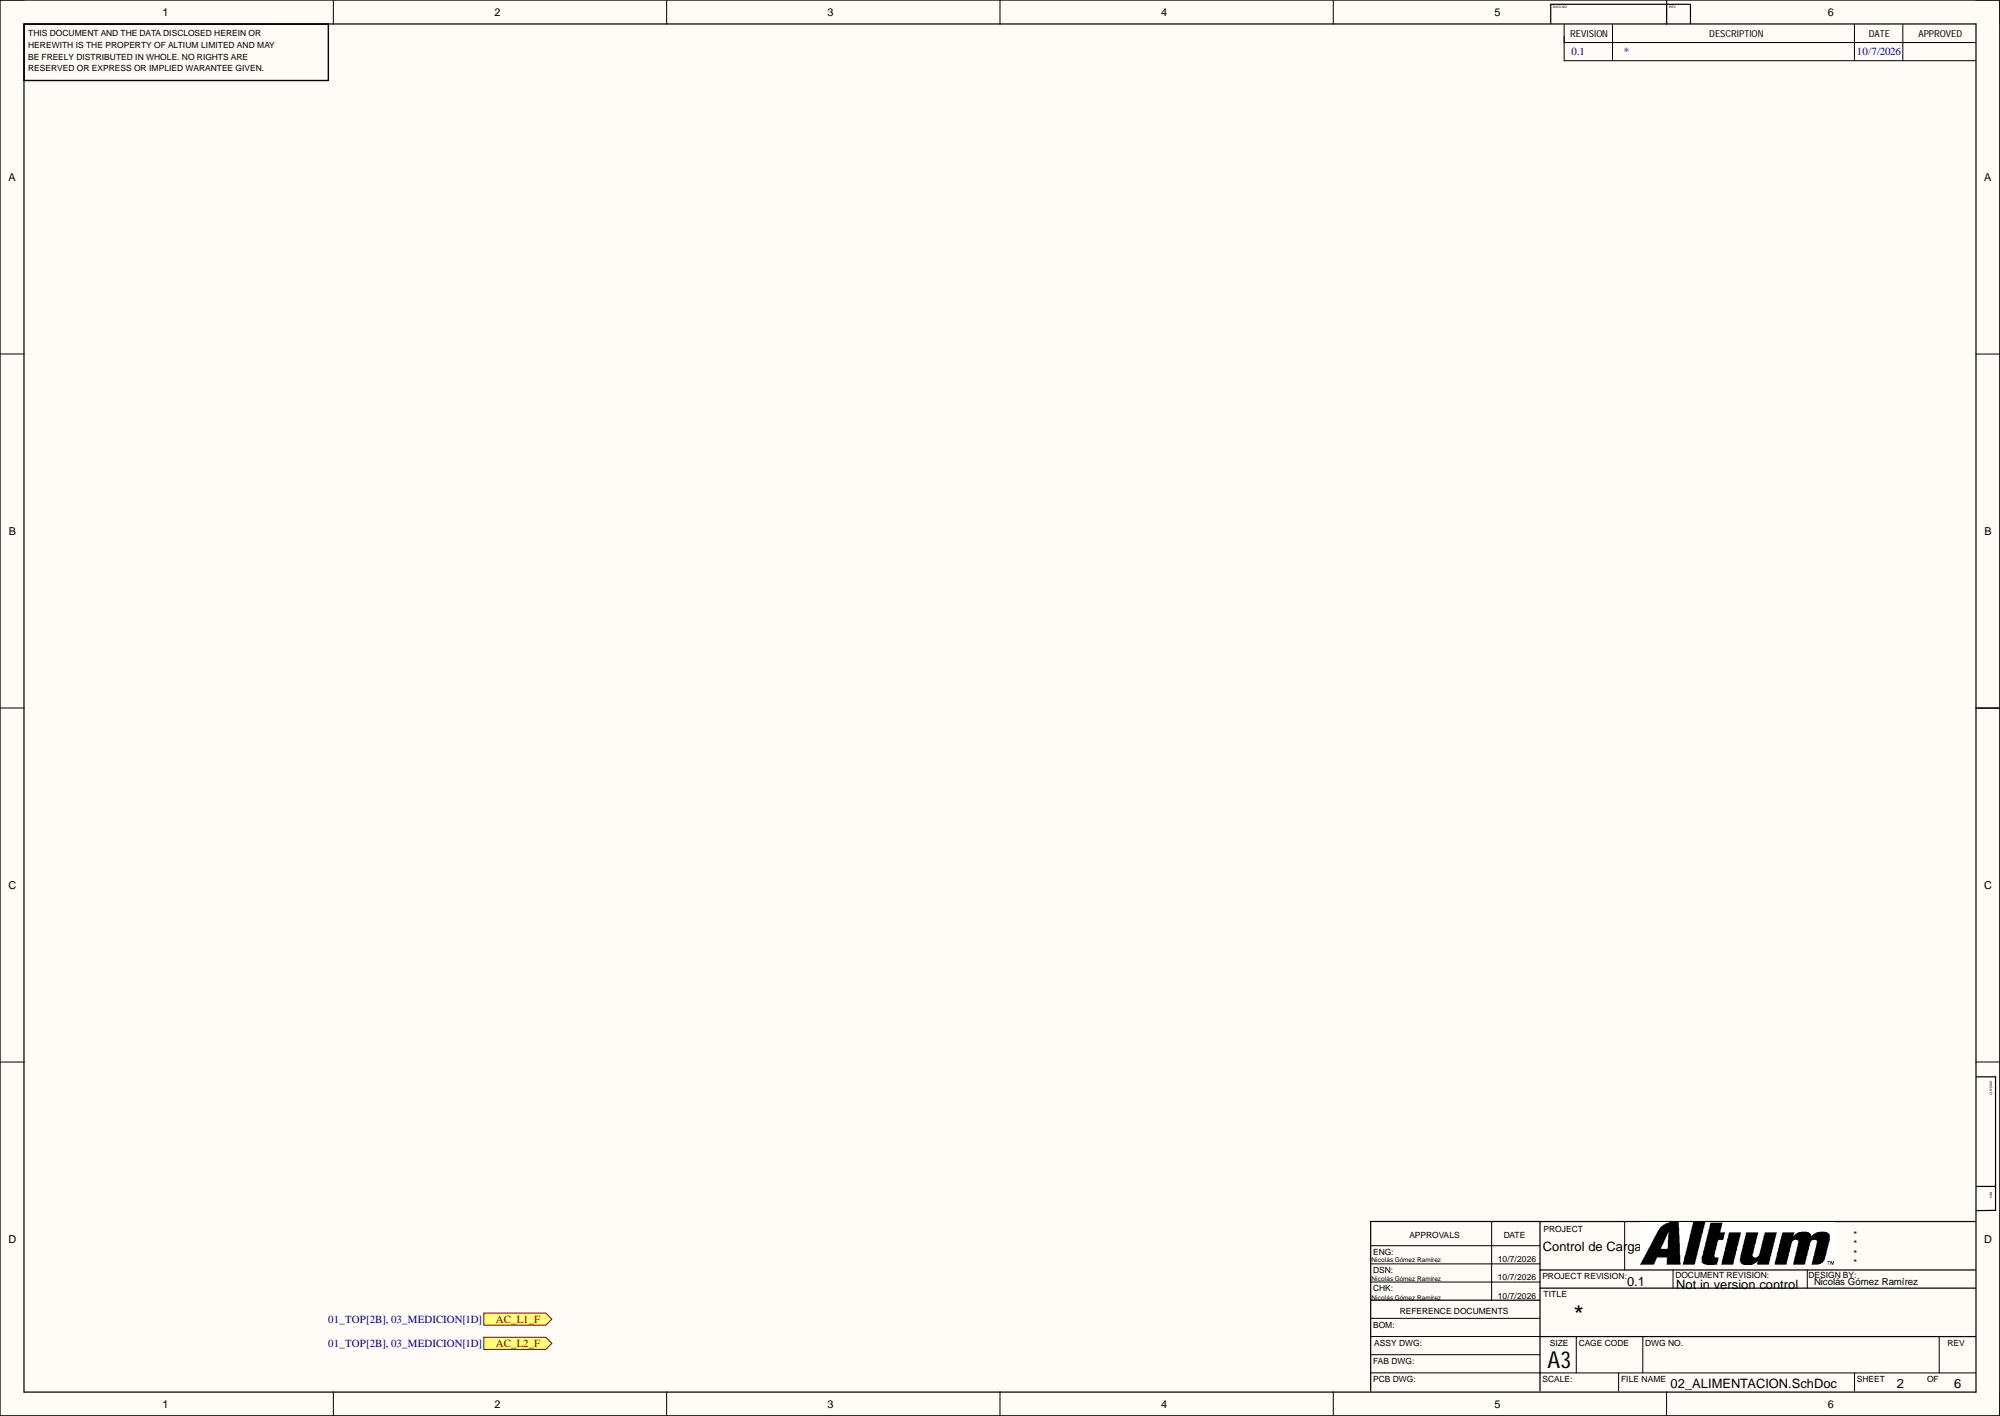
[picture p31: page 2]

DATE | PROJECT Control de Carga IoT.PrjPcb | * * APPROVALS * *

ENG: Nicolás Gómez Ramírez | 10/7/2026

DSN: Nicolás Gómez Ramírez | 10/7/2026

CHK: | 10/7/2026

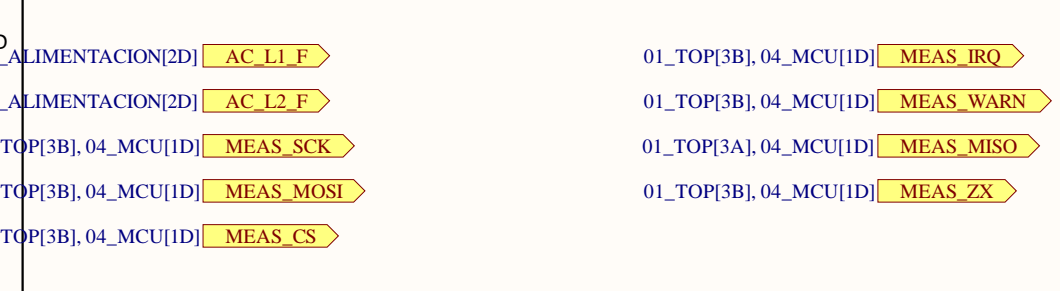
[picture p32: page 3]

THIS DOCUMENT AND THE DA TA DISCL OSED HEREIN O R HEREWITH IS THE PROPERTY OF ALTIUM LIMITED AND M AY BE FREELY DISTRIBUTED IN WHO LE. NO RIGHTS ARE | | REVISI O N | DESCRIPTI O N | DATE | APPROVED

DATE | PRO JECT Control de Carga IoT.P | **** APPROVALS rjPcb

ENG : DSN: Nicolás G ó mez Ram í rez | 1 0/7/2 0 2 6

N icol ás G ó mez Ram í rez | 1 0/7/2 0 2 6
CHK: N icol ás G ó mez Ram í rez | 0/7/2

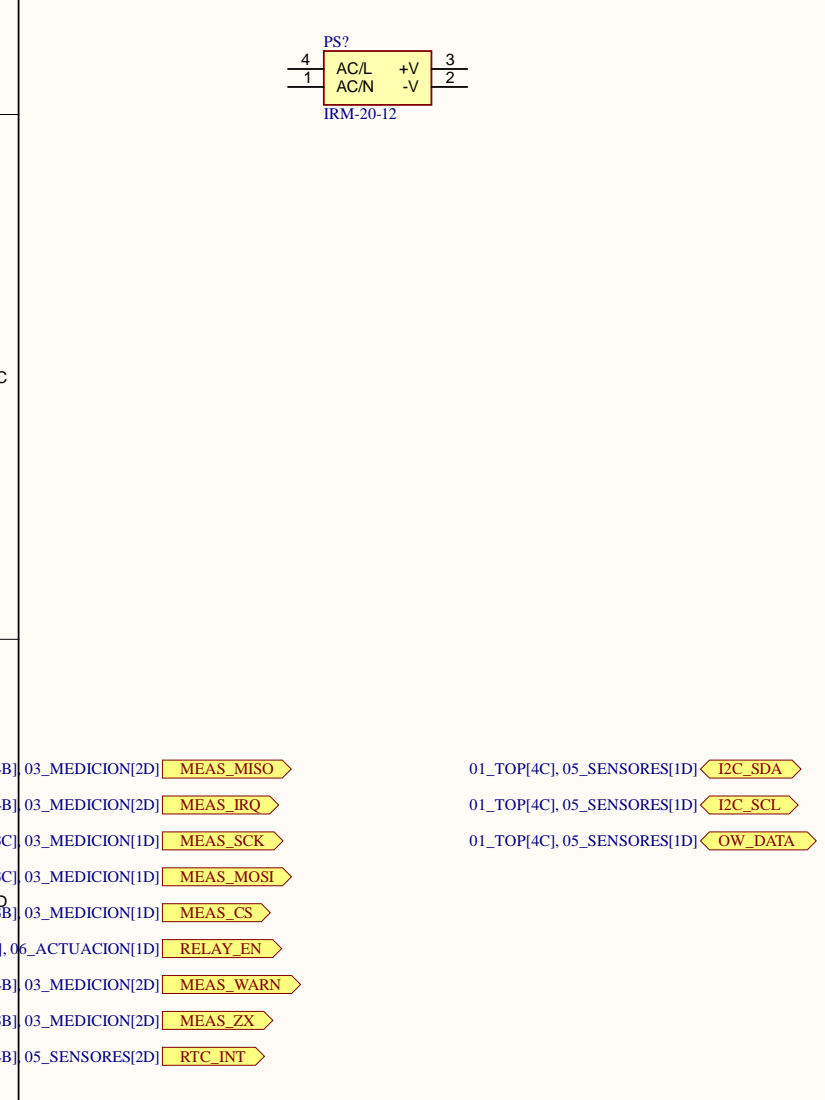
[picture p33: page 4]

DATE | PROJECT Control de Carga IoT.PrjPcb | * * APPROVALS * *

ENG: Nicolás Gómez Ramírez | 10/7/2026

DSN: Nicolás Gómez Ramírez | 10/7/2026

CHK: | 10/7/2026

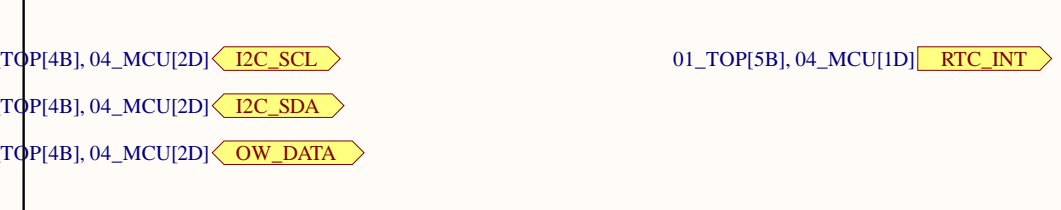
[picture p34: page 5]
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

DATE | PRO JECT Control de Carga IoT.P | **** APPROVALS rjPcb

ENG : DSN: Nicolás G ó mez Ram í rez | 1 0/7/2 0 2 6

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

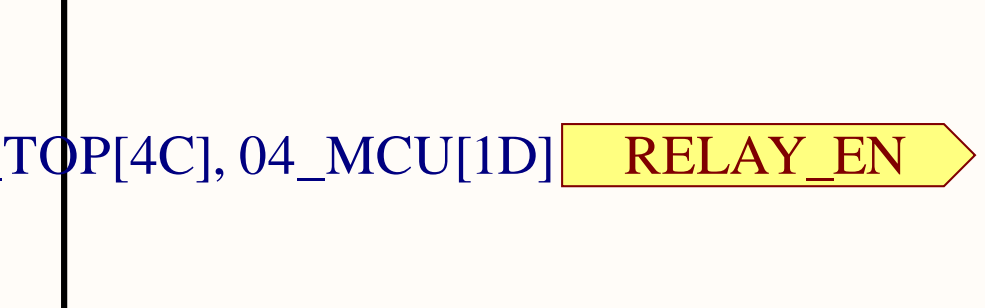
[picture p35: page 6]

DATE | PROJECT Control de Carga IoT.PrjPcb | * * APPROVALS * *

ENG: Nicolás Gómez Ramírez | 10/7/2026

DSN: Nicolás Gómez Ramírez | 10/7/2026

CHK: | 10/7/2026

Comment | Description | Designator | Footprint | LibRef | Quantity
IRM-20-12 | Power Supply | PS? | IRM2012 | IRM-20-12 | 1
