NicoGomez4262/control-carga-evse/docs/revisiones/PROYECTO_F4.pdf

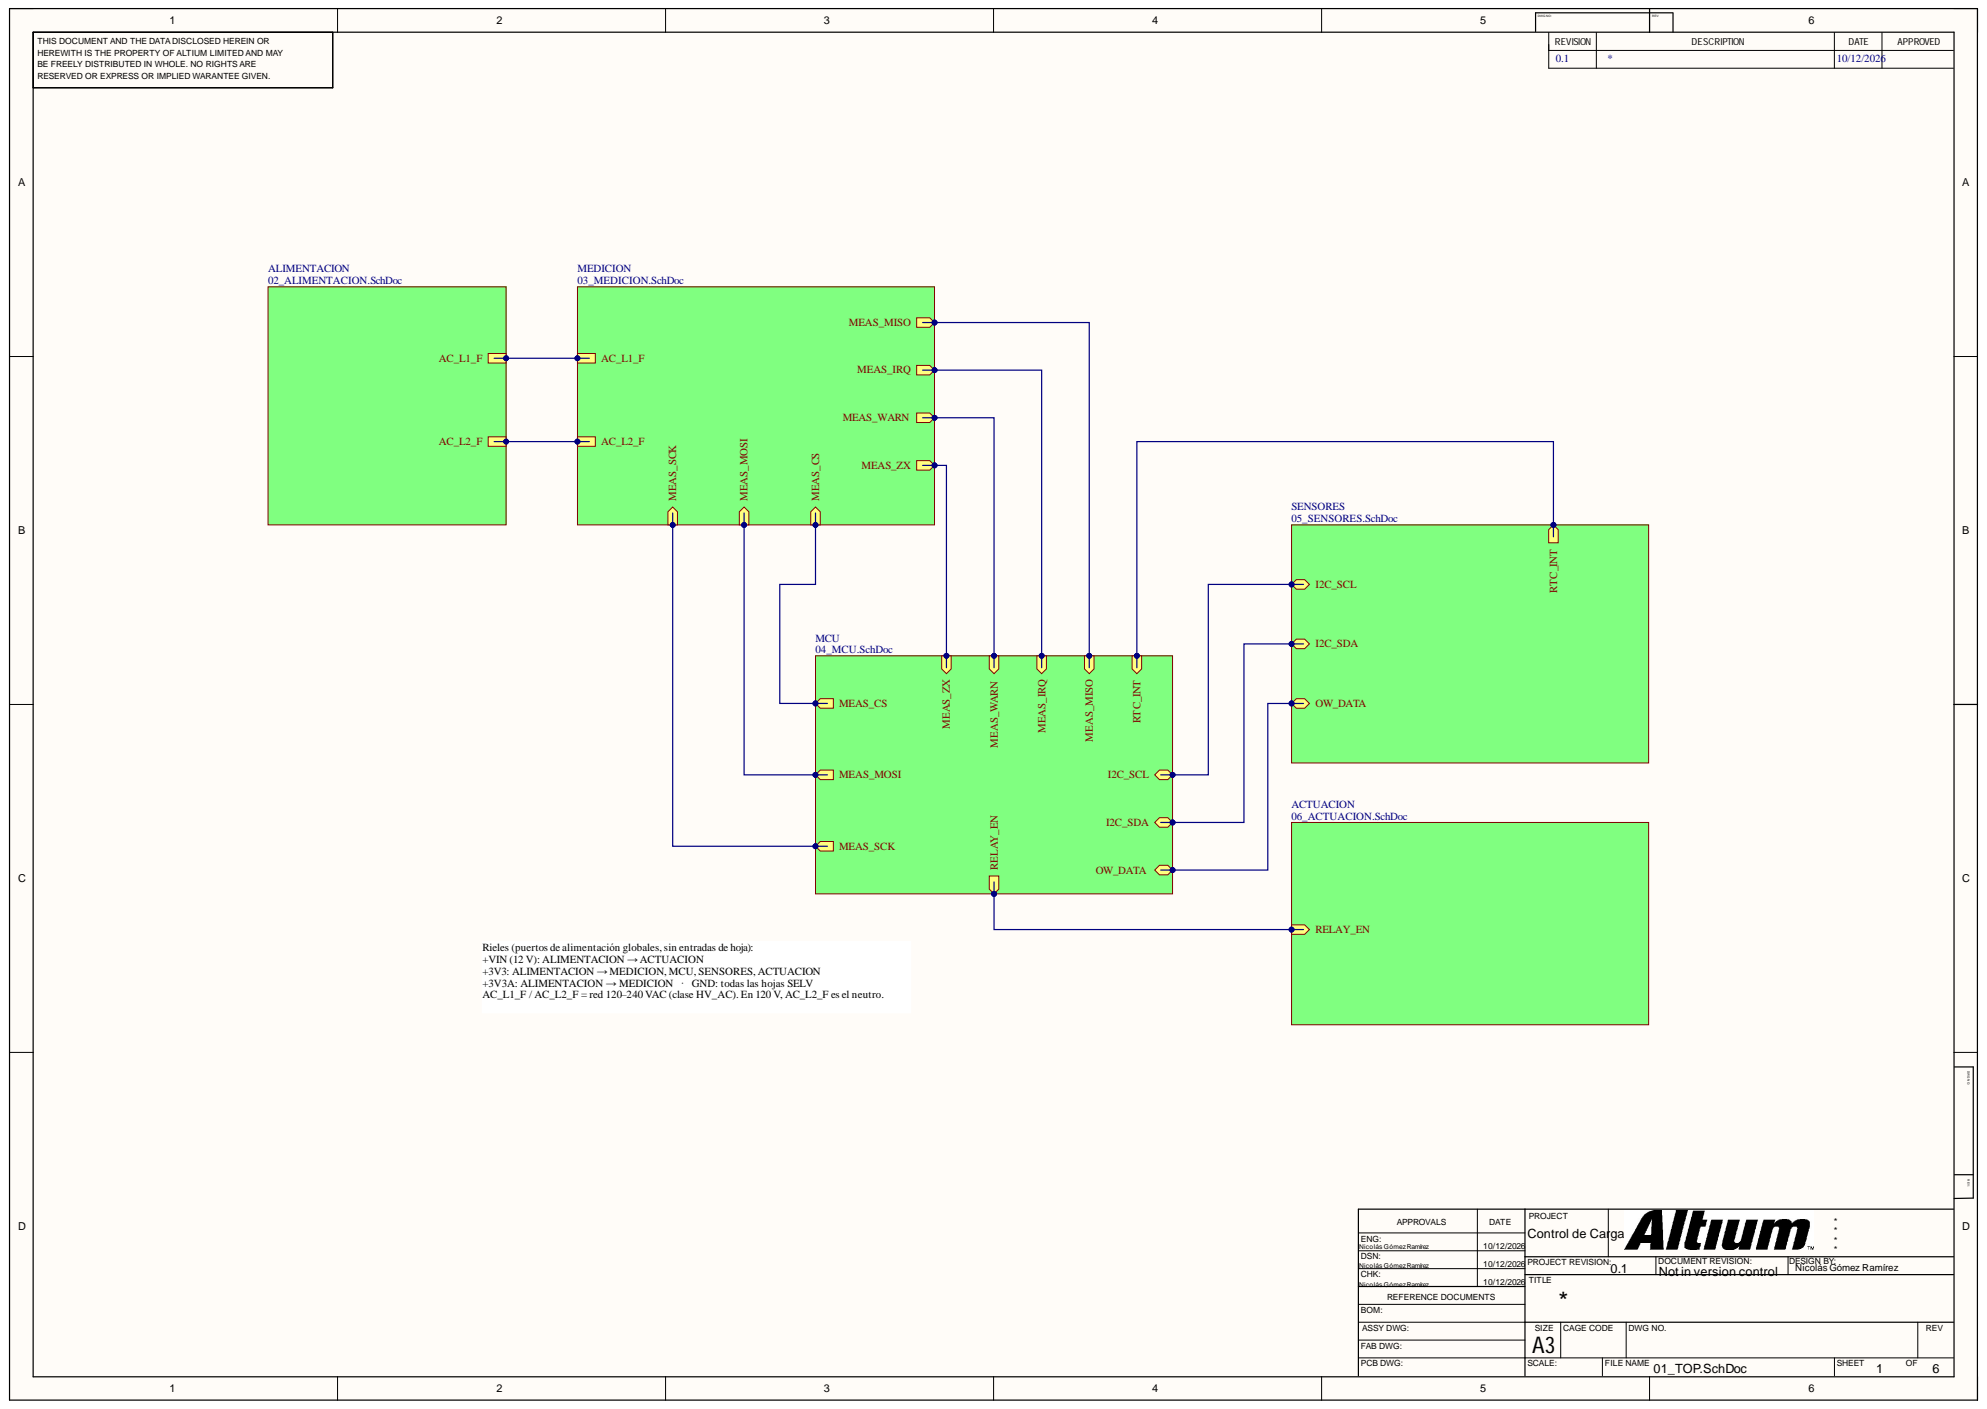
[picture p42: page 1]

DWG NO: | REV:

THIS DOCUMENT AND THE DATA DISCLOSED HEREIN OR HEREWITH IS THE PROPERTY OF ALTIUM LIMITED AND MAY BE FREELY DISTRIBUTED IN WHOLE. NO RIGHTS ARE RESERVED OR EXPRESS OR IMPLIED WARANTEE GIVEN. 02_ALIMENTACION.SchDoc | MEDICION 03_MEDICION.SchDoc | REVISION | DESCRIPTION | DATE | APPROVED

Rieles (puertos de alimentación globales,sin entradas de hoja):
+VIN (12 V): ALIMENTACION → ACTUACION
+3V3: ALIMENTACION → MEDICION, MCU, SENSORES, ACTUACION
+3V3A: ALIMENTACION → MEDICION · GND: todas las hojas SELV
AC_L1_F / AC_L2_F = red 120–240 VAC (clase HV_AC). En 120 V, AC_L2_F es el neutro.

DATE | PROJECT Control de Carga IoT.PrjPcb | * * APPROVALS * *

ENG: Nicolás GómezRamírez | 10/12/2026
CHK: Nicolás GómezRamírez | 10/12/2026 | TITLE *

DSN: Nicolás GómezRamírez | 10/12/2026 | 0.1 | DOCUMENT REVISION: Not in version control | DESIGN BY: Nicolás Gómez Ramírez PROJECT REVISION:

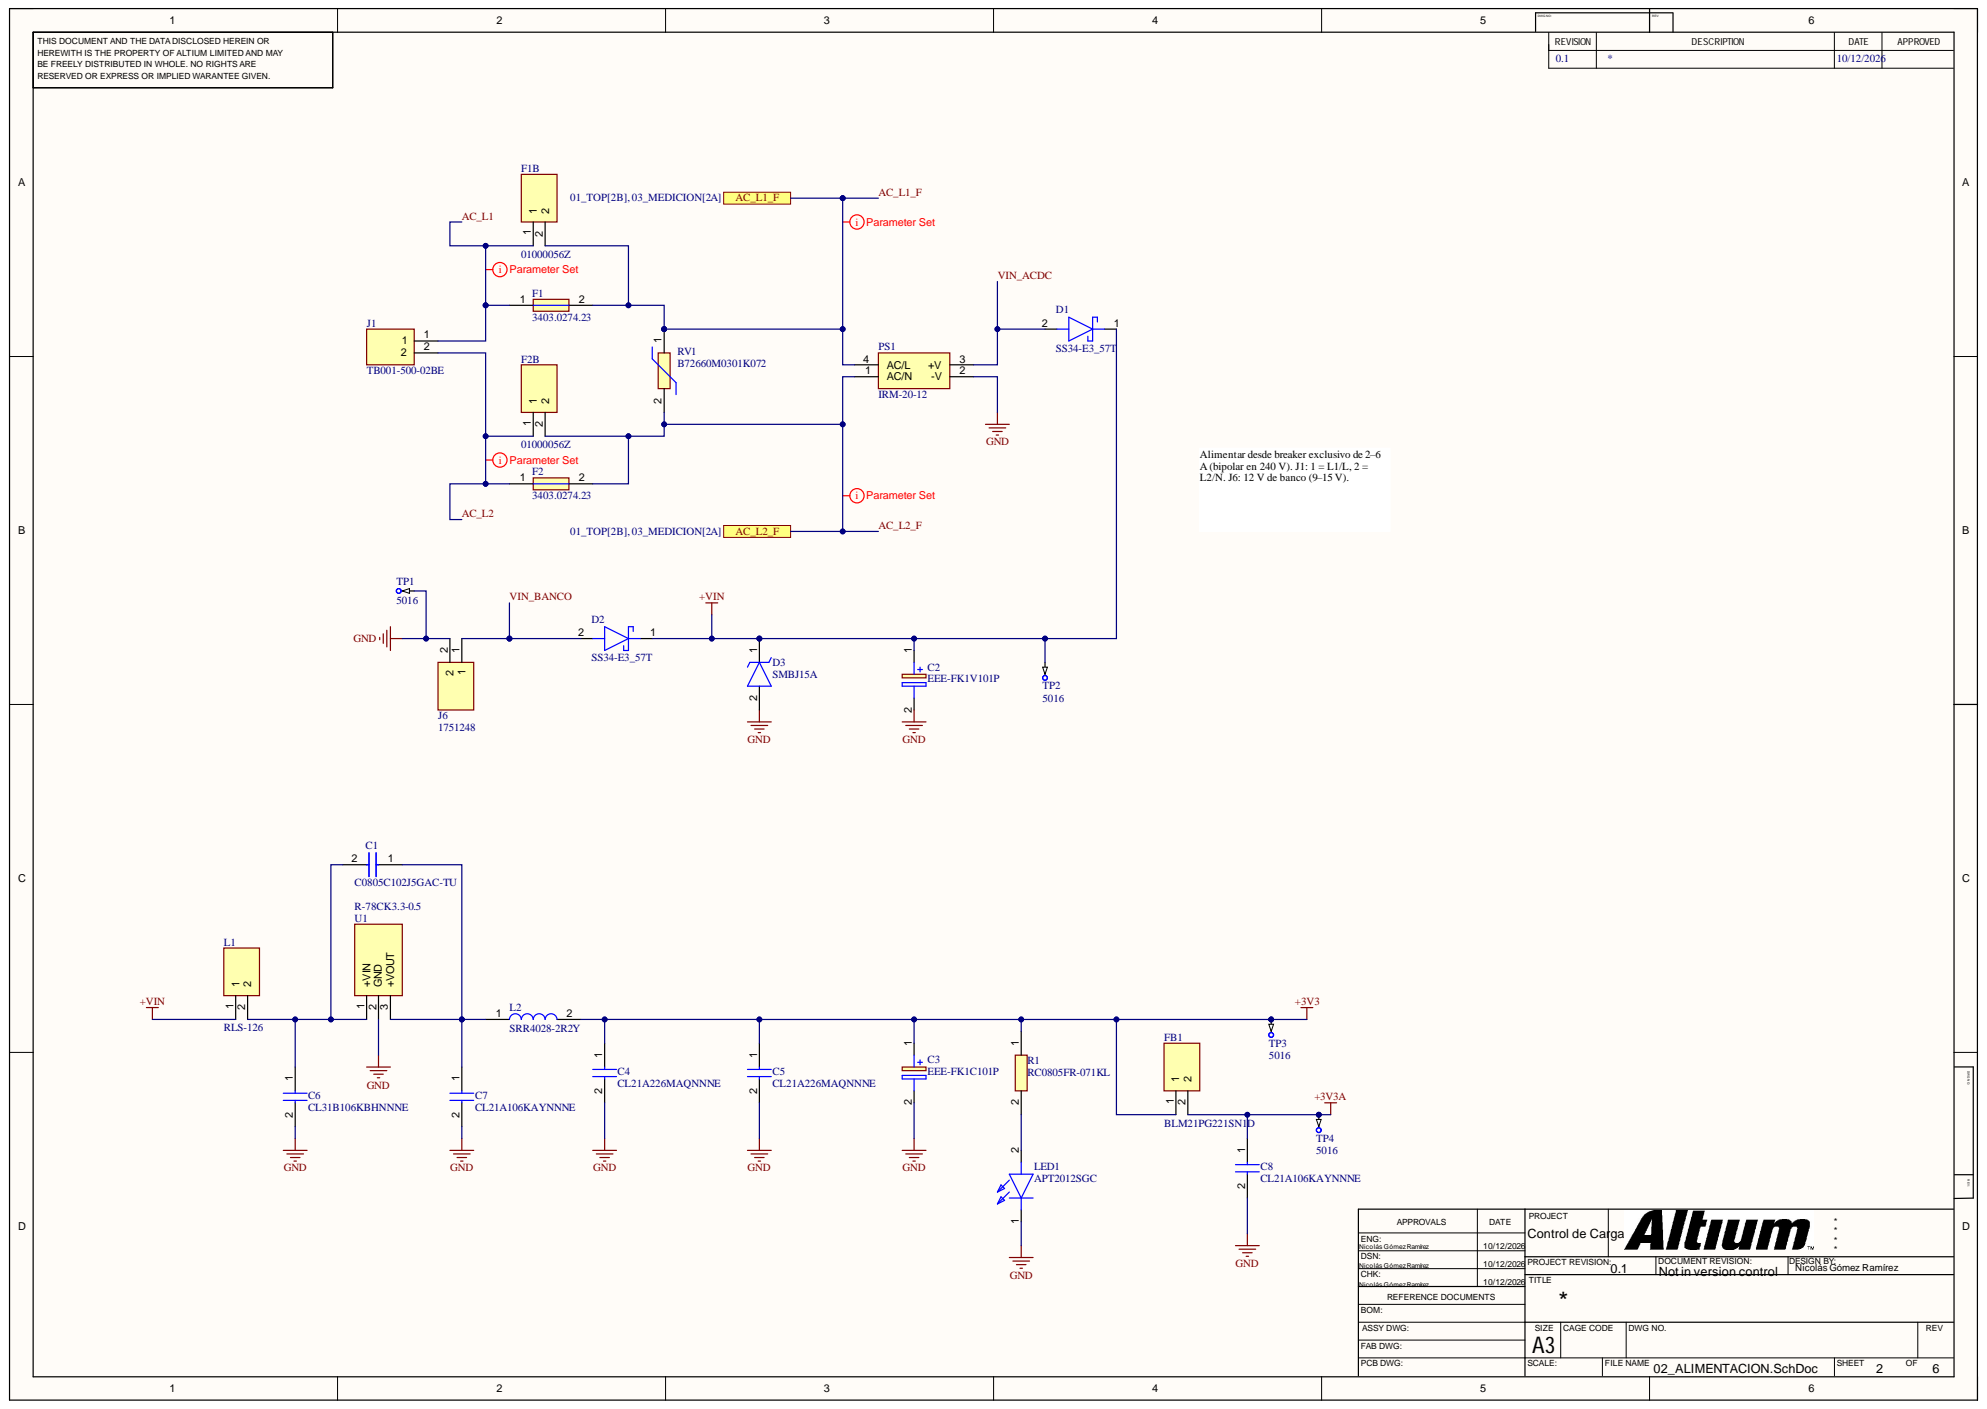
[picture p43: page 2]

RESERVED OR EXPRESS OR IMPLIED WARANTEE GIVEN.

Alimentar desde breaker exclusivo de 2–6
A (bipolar en 240 V). J1: 1 = L1/L, 2 =
L2/N. J6: 12 V de banco (9–15 V).

DATE | PROJECT Control de Carga IoT.PrjPcb | * * APPROVALS * *

ENG: Nicolás GómezRamírez | 10/12/2026

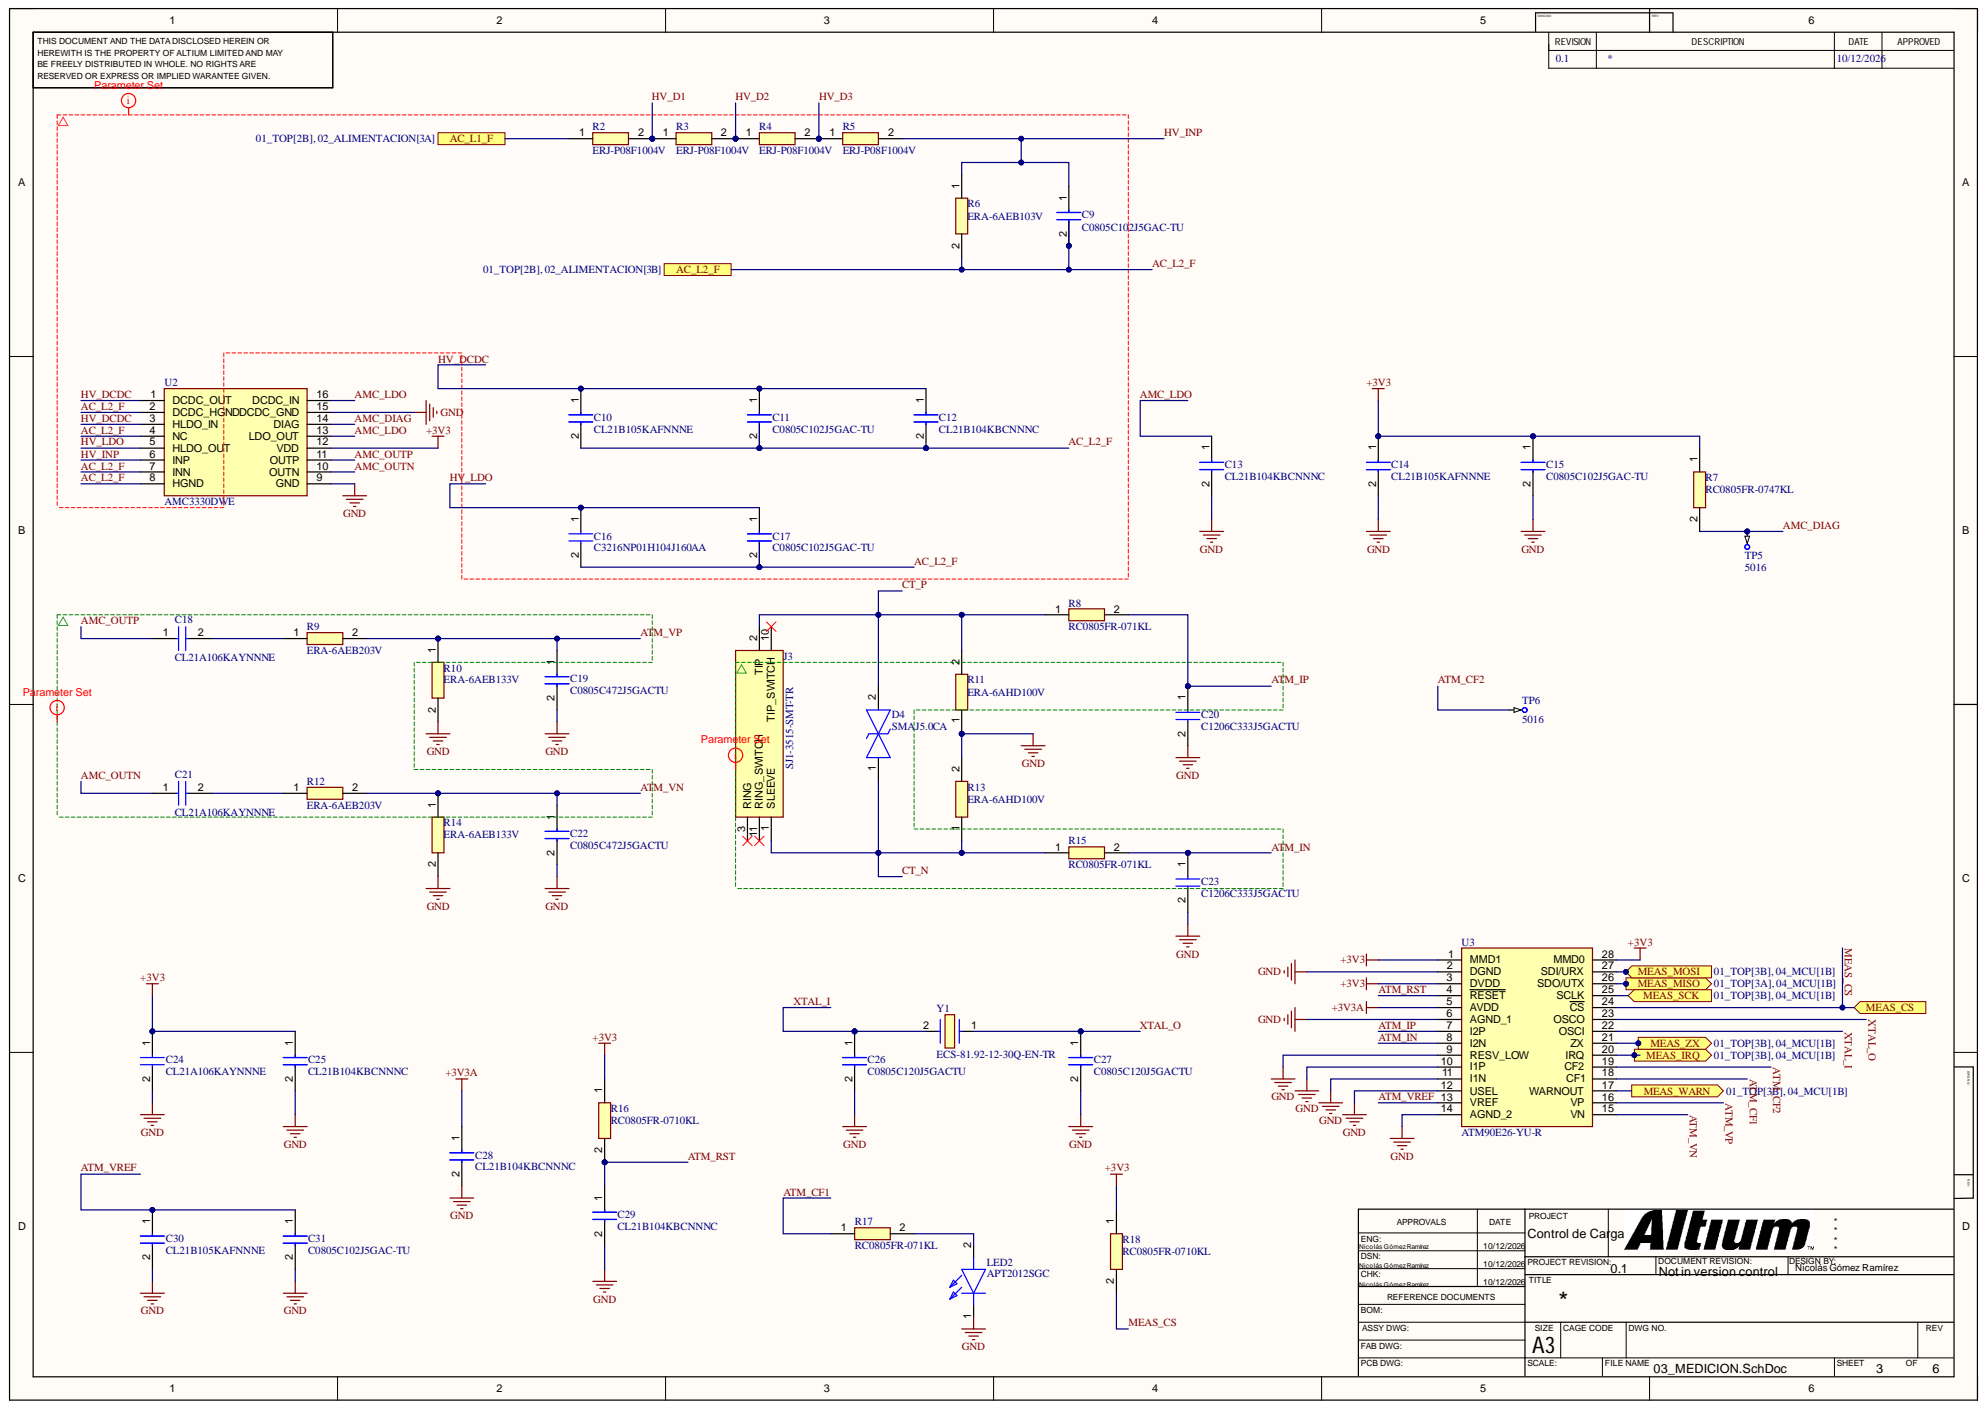
[picture p44: page 3]

RESERVED OR EXPRESS OR IMPLIED WARANTEE GIVEN.

DATE | PROJECT Control de Carga IoT.PrjPcb | * * APPROVALS * *

ENG: Nicolás GómezRamírez | 10/12/2026
CHK: Nicolás GómezRamírez | 10/12/2026 | TITLE *

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

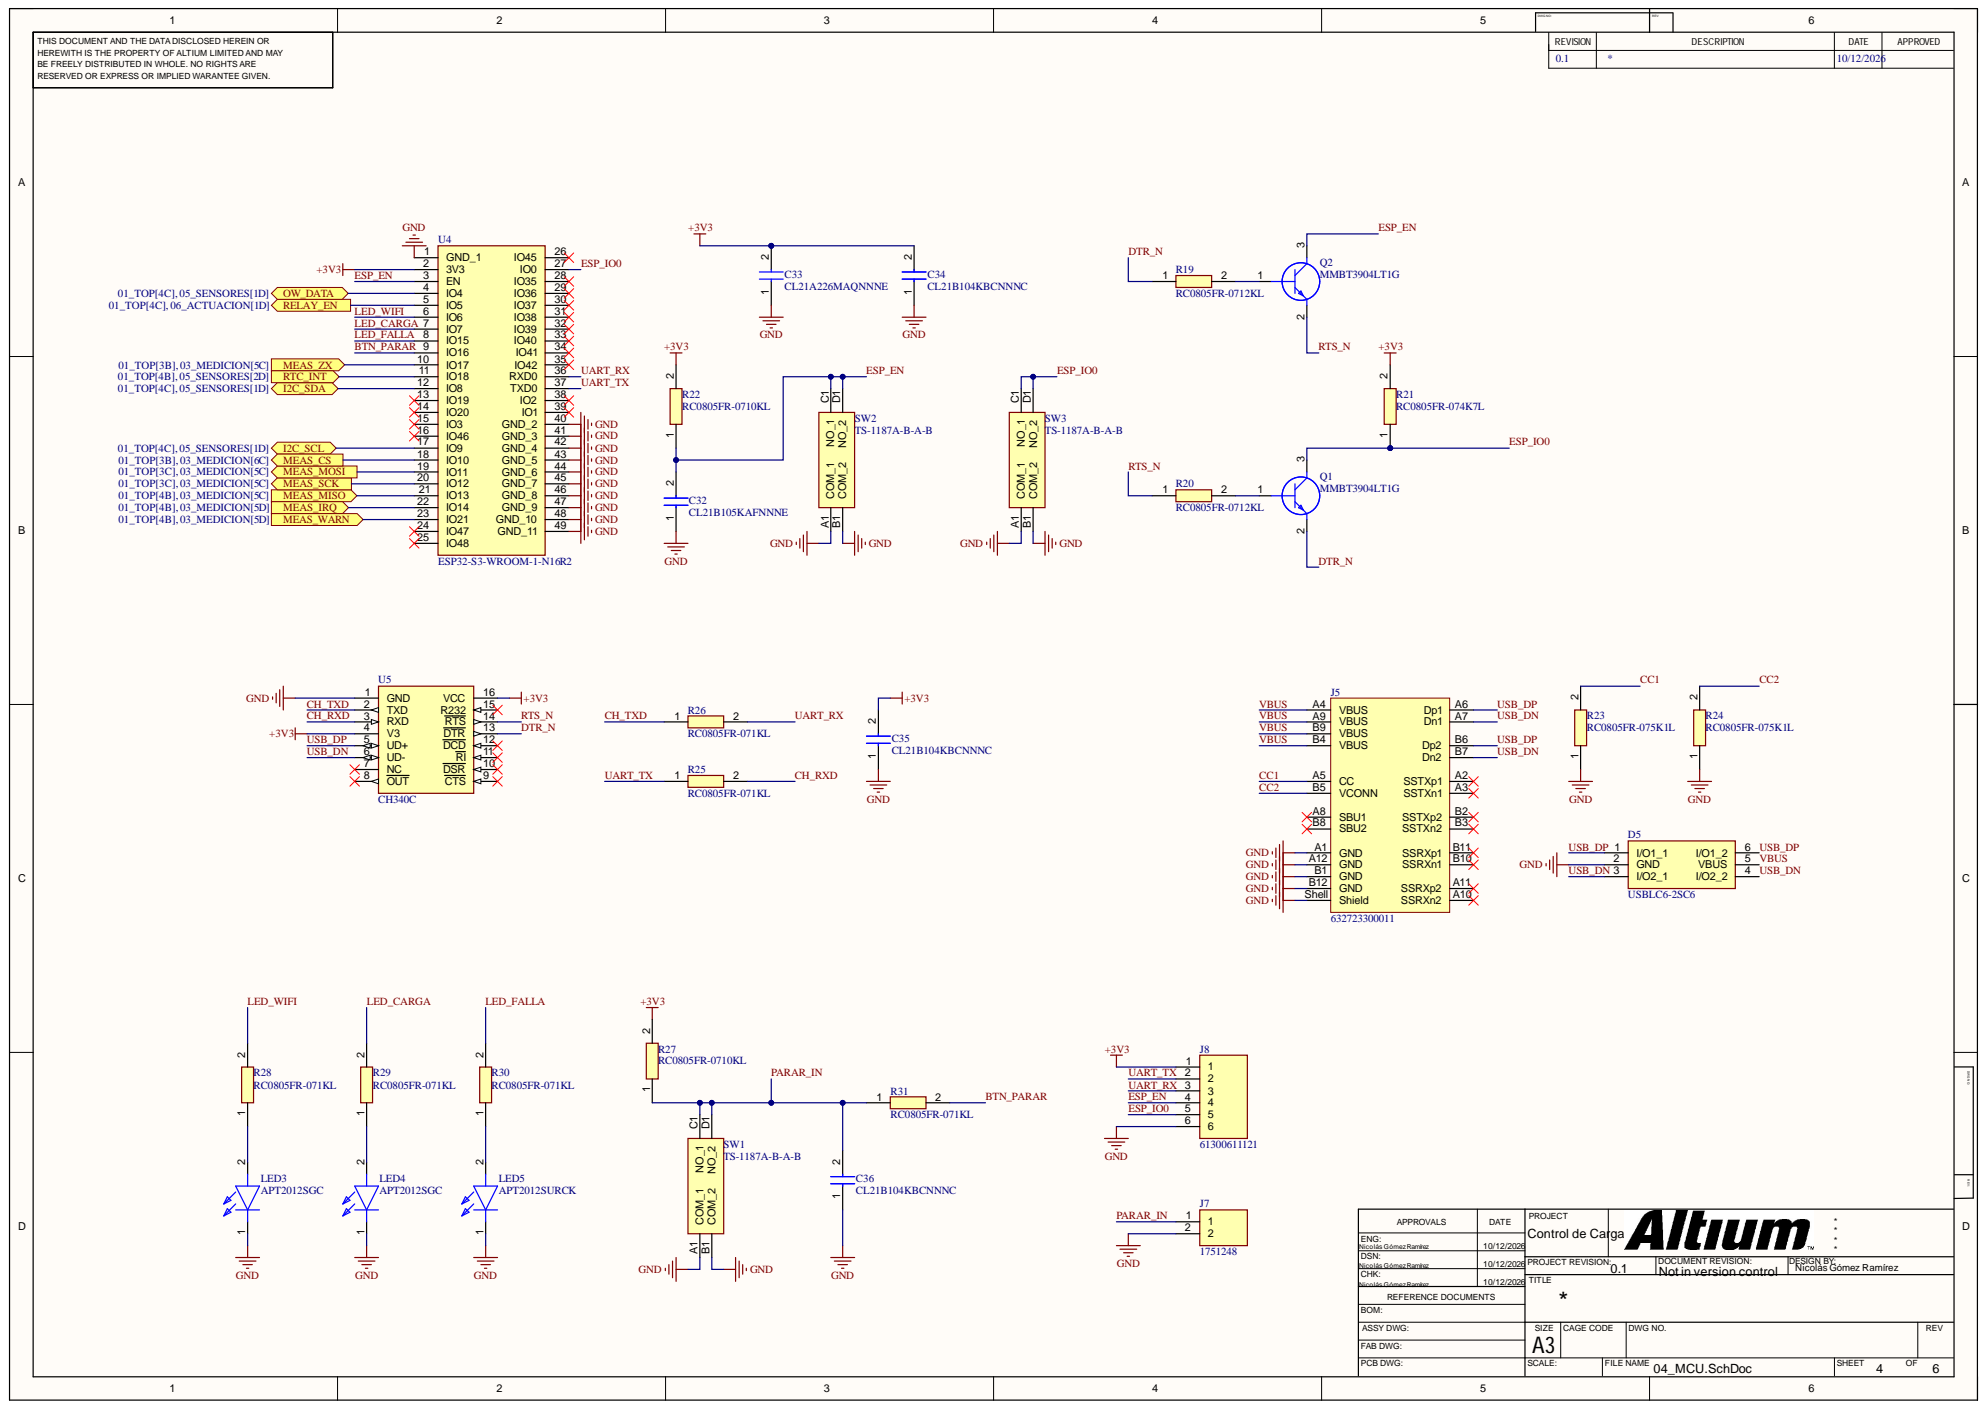
[picture p45: page 4]

RESERVED OR EXPRESS OR IMPLIED WARANTEE GIVEN.

ENG: Nicolás GómezRamírez | 10/12/2026
CHK: Nicolás GómezRamírez | 10/12/2026 | TITLE *

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

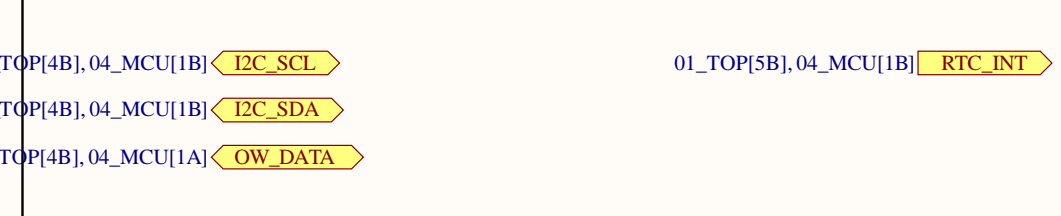
[picture p46: page 5]

THIS DOCUM ENT AND THE DATA DISCLOS ED HEREIN OR HERE WITH IS THE PROP ERT Y OF A LTIUM LIMIT ED AND M AY B E FRE E LY DIS TRIBUT ED IN WHOL E. NO RIGHT S ARE RE S ERV ED OR E X PRE S S OR IM P LIED W ARANT E E GIV EN. | | R E V I S I ON | D E S C R I PT I ON | D AT E | A P P R OVE D

A P PROV A L S | DAT E | PROJECT Co ntro l d e Carg | **** a Io T.PrjPc b

ENG: Ni c o l á s G ó m e zRa m írez | 1 0/1 2/2 0 2 | 6
CHK : Ni c o l á s G ó m e zRa m | 1 0/1 2/2 0 2 | 6 TIT L E *

DSN: Ni c o l á s G ó m e zRa m írez | 1 0/1 2/2 0 2 | 6 PROJECT RE VISION: 0 . 1 | DOCUM ENT RE VISION: Not | DE SIGN B Y : N icol ás G ó mez Ram í rez

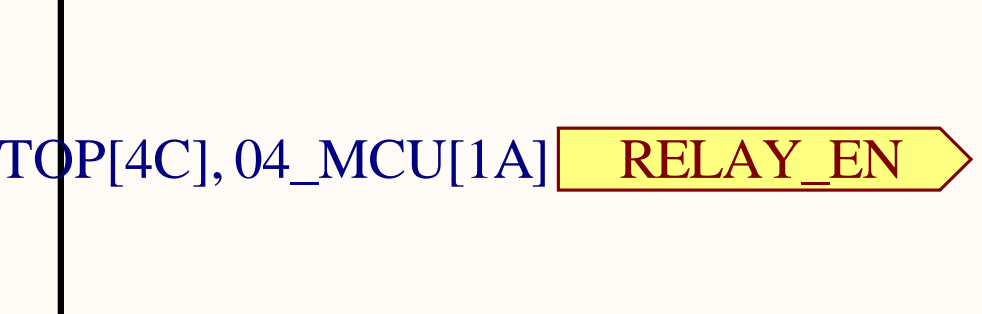
[picture p47: page 6]

RESERVED OR EXPRESS OR IMPLIED WARANTEE GIVEN.

DATE | PROJECT Control de Carga IoT.PrjPcb | * * APPROVALS * *

ENG: Nicolás GómezRamírez | 10/12/2026
CHK: Nicolás GómezRamírez | 10/12/2026 | TITLE *

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

Comment | Description | Designator | Footprint | LibRef | Quantity
C0805C102J5GAC-TU | Capacitor | C1, C9, C11, C15, C17, C31 | CAPC2012X88N | C0805C102J5GAC-TU | 6
EEE-FK1V101P | Capacitor Polarised | C2 | EEHZT1E331UP | EEE-FK1V101P | 1
EEE-FK1C101P | Capacitor Polarised | C3 | EEE1AA101SP | EEE-FK1C101P | 1
CL21A226MAQNNNE | Capacitor | C4, C5, C33 | CAPC2012X140N | CL21A226MAQNNNE | 3
CL31B106KBHNNNE | Capacitor | C6 | CAPC3216X180N | CL31B106KBHNNNE | 1
CL21A106KAYNNNE | Capacitor | C7, C8, C18, C21, C24 | CAPC2012X145N | CL21A106KAYNNNE | 5
CL21B105KAFNNNE | Capacitor | C10, C14, C30, C32 | CAPC2012X88N | CL21B105KAFNNNE | 4
CL21B104KBCNNNC | Capacitor | C12, C13, C25, C28, C29, C34, C35, C36 | CAPC2012X88N | CL21B104KBCNNNC | 8
C3216NP01H104J160A A | Capacitor | C16 | CAPC3216X180N | C3216NP01H104J160A A | 1
C0805C472J5GACTU | Capacitor | C19, C22 | CAPC2012X88N | C0805C472J5GACTU | 2
C1206C333J5GACTU | Capacitor | C20, C23 | CAPC3216X180N | C1206C333J5GACTU | 2
C0805C120J5GACTU | Capacitor | C26, C27 | CAPC2012X88N | C0805C120J5GACTU | 2
SS34-E3_57T | SchottkyDiode | D1, D2 | DIOM7959X262N | SS34-E3_57T | 2
SMBJ15A | TVSDiode(Uni-directional) | D3 | DIOM5436X244N | SMBJ15A | 1
SMAJ5.0CA | TVSDiode(Bi-directional) | D4 | DIONM5026X229N | SMAJ5.0CA | 1
USBLC6-2SC6 | Integrated Circuit | D5 | SOT95P280X145-6N | USBLC6-2SC6 | 1
3403.0274.23 | Fuse | F1, F2 | 3403027423 | 3403.0274.23 | 2
01000056Z | Undefined or Miscellaneous | F1B, F2B | 01000056Z | 01000056Z | 2
BLM21PG221SN1D | FerriteBead | FB1 | BEADC2012X105N | BLM21PG221SN1D | 1
TB001-500-02BE | Connector | J1 | TB001-500-02BE | TB001-500-02BE | 1
SJ1-3515-SMT-TR | Connector | J3 | SJ13515SMTTR | SJ1-3515-SMT-TR | 1
632723300011 | Conn USB3.1TypeC RCP24POS 0.5mm/0.4mm Solder RASMD/Thru-Hole24 Terminal 1Port T/R | J5 | 632723300011 | CMP-1502-03214-4 | 1
1751248 | Connector | J6, J7 | 1751248 | 1751248 | 2
61300611121 | Connector | J8 | HDRV6W79P0X254_1X 6_1524X254X894P | 61300611121 | 1
RLS-126 | Power Supply | L1 | RLS126 | RLS-126 | 1
SRR4028-2R2Y | Inductor | L2 | SRR4028 | SRR4028-2R2Y | 1
APT2012SGC | LED | LED1, LED2, LED3, LED4 | LEDC2012X85N | APT2012SGC | 4
APT2012SURCK | LED | LED5 | LEDC2012X85N | APT2012SURCK | 1
IRM-20-12 | Power Supply | PS1 | IRM2012 | IRM-20-12 | 1
MMBT3904LT1G | Transistor BJTNPN | Q1, Q2 | SOT96P237X111-3N | MMBT3904LT1G | 2
RC0805FR-071KL | Resistor | R1, R8, R15, R17, R25, R26, R28, R29, R30, R31 | RESC2012X60N | RC0805FR-071KL | 10
ERJ-P08F1004V | Resistor | R2, R3, R4, R5 | ERJP08_(1206) | ERJ-P08F1004V | 4
ERA-6AEB103V | Resistor | R6 | RESC2012X60N | ERA-6AEB103V | 1
RC0805FR-0747KL | Resistor | R7 | RESC2012X60N | RC0805FR-0747KL | 1
ERA-6AEB203V | Resistor | R9, R12 | RESC2012X60N | ERA-6AEB203V | 2
ERA-6AEB133V | Resistor | R10, R14 | RESC2012X60N | ERA-6AEB133V | 2
ERA-6AHD100V | Resistor | R11, R13 | RESC2012X60N | ERA-6AHD100V | 2
RC0805FR-0710KL | Resistor | R16, R18, R22, R27 | RESC2012X60N | RC0805FR-0710KL | 4
RC0805FR-0712KL | Resistor | R19, R20 | RESC2012X60N | RC0805FR-0712KL | 2
RC0805FR-074K7L | Resistor | R21 | RESC2012X60N | RC0805FR-074K7L | 1
RC0805FR-075K1L | Resistor | R23, R24 | RESC2012X60N | RC0805FR-075K1L | 2
B72660M0301K072 | Varistor | RV1 | CU4032 | B72660M0301K072 | 1
TS-1187A-B-A-B | Tact switch 5.1x5.1x 1.5mm, 160gf, 50mA 12VDC | SW1, SW2, SW3 | TS1187ABAB | TS-1187A-B-A-B | 3
5016 | Test Point, 1-Pin SMT, RoHS, Tapeand Reel | TP1, TP2, TP3, TP4, TP5, TP6 | KEYSTONE-5016_V | CMP-2000-05178-1 | 6
R-78CK3.3-0.5 | Regulador conmutado 3.3V0.5 A, SIP3 | U1 | R78CK3305 | R-78CK3.3-0.5 | 1
AMC3330DWE | Integrated Circuit | U2 | SOIC127P1030X265-16N | AMC3330DWE | 1
ATM90E26-YU-R | Integrated Circuit | U3 | SOP65P778X199-28N | ATM90E26-YU-R | 1
ESP32-S3-WROOM-1-N16R2 | Integrated Circuit | U4 | ESP32S3WROOM1N16 R2 | ESP32-S3-WROOM-1-N16R2 | 1
CH340C | USBto UARTbridge | U5 | SOIC127P600X175-16N | CH340C | 1
ECS-81.92-12-30Q-EN-TR | Crystal or Oscillator | Y1 | ECS81921230QENTR | ECS-81.92-12-30Q-EN-TR | 1
