NicoGomez4262/control-carga-evse/docs/fabricacion/Ensamble_EVSE_Monitor.pdf

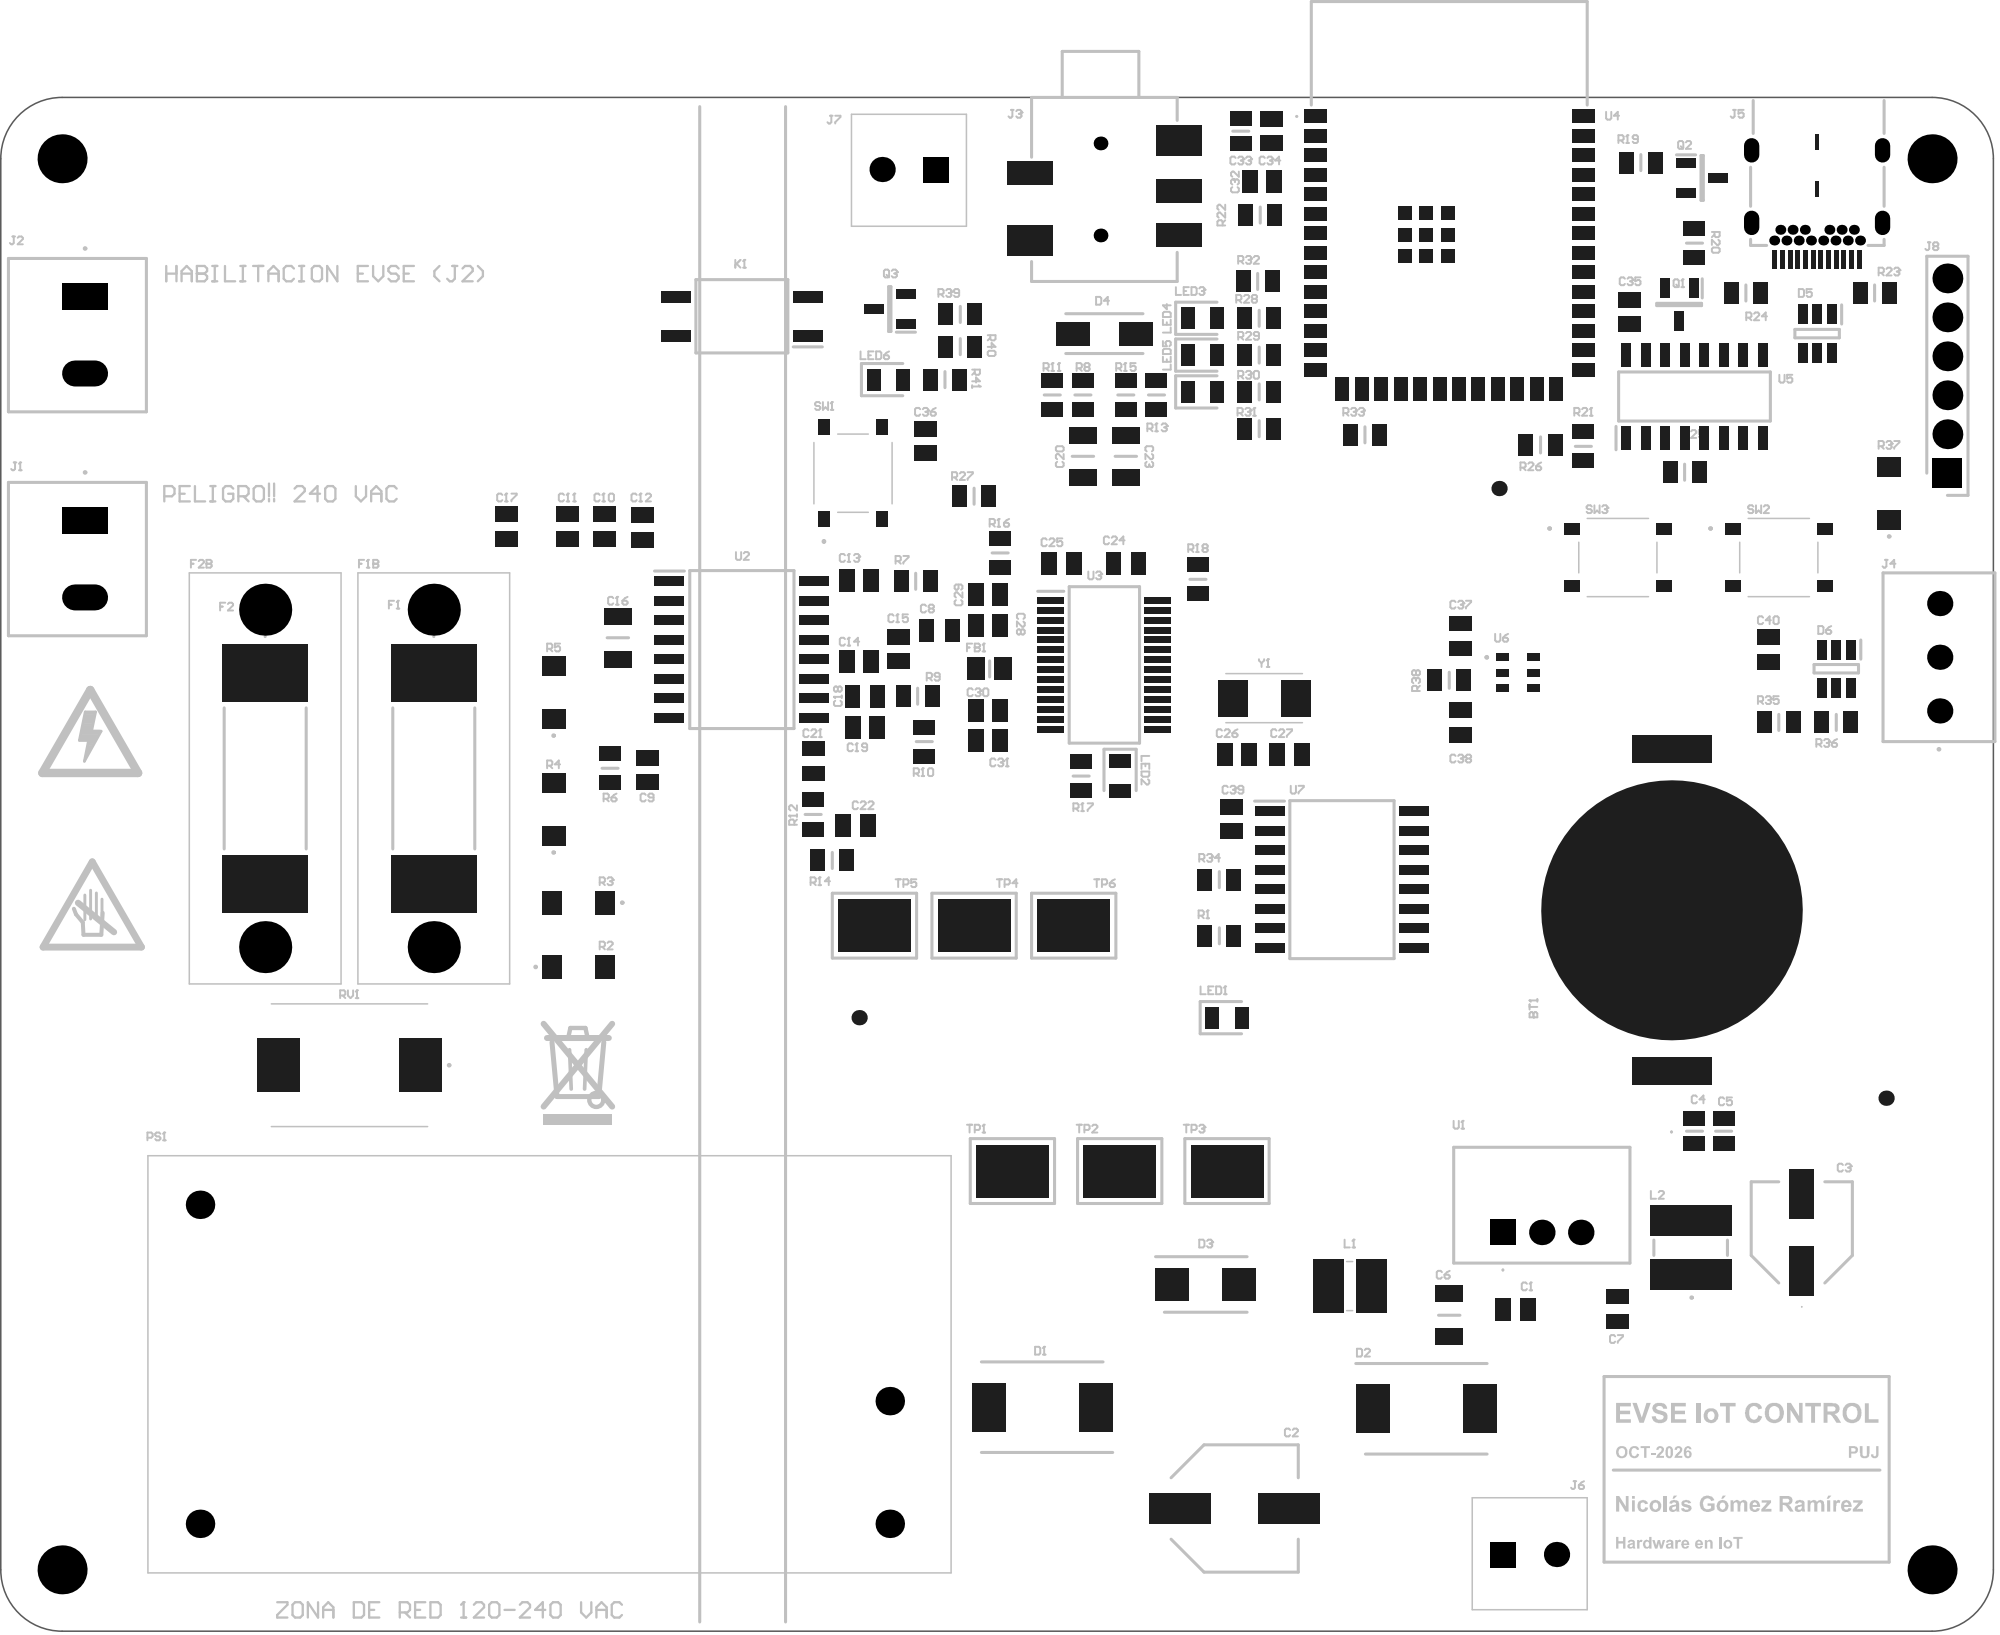
[picture p55: page 1]
