NicoGomez4262/control-carga-evse/(list of files, drawings)

Other design files:
altium/01_TOP.SchDoc
altium/02_ALIMENTACION.SchDoc
altium/03_MEDICION.SchDoc
altium/04_MCU.SchDoc
altium/05_SENSORES.SchDoc
altium/06_ACTUACION.SchDoc
altium/Control de Carga IoT.PrjPcb
altium/EVSE_Monitor.PcbDoc
altium/templates/EVSE_A3.SchDoc
