NicoGomez4262/control-carga-evse/(commit log)

2026-10-19 Control de carga EVSE: esquemático de las seis hojas y documentación
    Medidor IoT para el cargador de un carro eléctrico (ESP32-S3, ATM90E26,
    AMC3330 y PhotoMOS con aislamiento reforzado). Incluye el plan por fases,
    el registro de decisiones, los cálculos, los esquemas por bloque, los PDF
    de revisión y los scripts que revisan el proyecto de Altium.
2026-10-19 Agrega el proyecto de Altium (altium/) y el script que lo mantiene al día
    altium/ es el espejo de las fuentes del proyecto de trabajo: el .PrjPcb, las
    seis hojas, la PCB, el OutJob, la plantilla A3 y las librerías. Se actualiza
    con docs/tools/sincronizar_altium.py, que copia lo que cambió y, con
    --commit, hace commit y push de todo el repositorio. CLAUDE.md pide correrlo
    al terminar cada sesión. .gitattributes guarda los archivos de Altium byte
    por byte.
    [01_TOP.SchDoc, 02_ALIMENTACION.SchDoc, 03_MEDICION.SchDoc, 04_MCU.SchDoc, 05_SENSORES.SchDoc, 06_ACTUACION.SchDoc, Control de Carga IoT.PrjPcb, EVSE_A3.SchDoc]
2026-10-20 F7 (avance): directiva HV_AC de 03 en el borde de su Blanket; regla de compras D16 (PCBWay + DigiKey, Sigma último recurso); gabinete fuera de tareas; prompt para seguir F7
    [03_MEDICION.SchDoc]
2026-10-20 F7 (cierre): BOM con la regla D16/D17 (PCBWay turnkey, K1 por DigiKey a mano), proveedores y montaje por script en la librería y las hojas, revisión de diseño, PDF y BOM de F7, títulos acortados; NEX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
    [01_TOP.SchDoc, 02_ALIMENTACION.SchDoc, 03_MEDICION.SchDoc, 04_MCU.SchDoc, 05_SENSORES.SchDoc, 06_ACTUACION.SchDoc, F7_BOM.csv]
2026-10-22 F8 (cierre): ruteo terminado y verificado, planos de GND, archivos para PCBWay, carrito y explicación del diseño; NEXT_SESSION de F9
    [BOM_PCBWay.csv, BOM_PCBWay.xlsx, Control de Carga IoT.PrjPcb, EVSE_Monitor.PcbDoc, PickPlace_PCBWay.csv]
2026-10-23 F9 (preparación): guía del pedido en grupo en PCBWay y DigiKey, línea de Bulk Add y carrito con el envío del 22 oct
2026-10-23 F9 (preparación): TP1–TP6 a ronghe RH-5016 (Keystone 5016 en 0 en LCSC), conteo del formulario (118 SMD, 8 THT, 2 BGA/QFP), guía con cada campo de PCBWay, DigiKey con K1 y repuestos (US$ 17,87, cupo 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
    [02_ALIMENTACION.SchDoc, 03_MEDICION.SchDoc, BOM_PCBWay.csv, BOM_PCBWay.xlsx, PickPlace_PCBWay.csv]
2026-10-23 F9 (preparación): esquinas de R 4 mm concéntricas con M1–M4, bloque de identificación en la serigrafía (TrueType Arial Bold), textos libres al mínimo de PCBWay, notas de ensamble bajo 600 caracteres;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
    [EVSE_Monitor.PcbDoc]
2026-10-23 F9 (preparación): símbolos de alta tensión, RAEE y ESD en la zona de red; tarjeta con QR estático a nicolasgomez.dev atrás (decodificado con zxing); Made by a 0,8 mm; guía A0 para Repour All y OutJob
    [EVSE_Monitor.PcbDoc]
2026-10-23 F9 (preparación): archivos finales para PCBWay con esquinas redondeadas, bloque de identificación, símbolos y QR; relleno del QR devuelto a su lugar; Gerber revisados (QR leído desde el GBO)
    [EVSE_Monitor.PcbDoc]
2026-10-23 F9 (preparación): BT1 girado por el usuario; gotas_f9.py (178 uniones sin gota, cobre de GND montado sobre RTC_VBAT); guía A0 para gotas y Repour, A2 para reemplazar el pedido en PCBWay
    [EVSE_Monitor.PcbDoc]
2026-10-23 F9 (preparación): Repour después de girar BT1 (el GND ya no se monta sobre RTC_VBAT); faltan las gotas y el OutJob
    [EVSE_Monitor.PcbDoc]
2026-10-23 F9 (preparación): paquete final para PCBWay (23 oct 14:04) con BT1 girado y Repour; Gerber revisados, sin corto en RTC_VBAT, QR leído
    [PickPlace_PCBWay.csv]
2026-10-23 F9 (preparación): sin DigiKey (D19). K1 AQY414EHAX lo compra y lo suelda PCBWay (DigiKey/Mouser) y F1/F2 llevan 2 fusibles 3403.0274.11 de repuesto; BOM, Pick & Place (127 piezas), notas (597 caracte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
    [06_ACTUACION.SchDoc, BOM_PCBWay.csv, BOM_PCBWay.xlsx, EVSE_Monitor.PcbDoc, PickPlace_PCBWay.csv]
2026-10-23 F9 (preparación): documento Word de 3 páginas con la descripción general de la PCB (objetivos iniciales, funcionamiento, hojas 01–06, PCB y fabricación)
2026-10-23 F9 (preparación): paquete revisado contra la PCB (OutJob de las 16:01: Gerber iguales en geometría, 304 taladros, P&P = centro de pads, BOM = P&P = PcbDoc); Word con K1 comprado por PCBWay y costo si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
2026-10-23 README nuevo: estado F9, cifras de la PCB, render 3D, layout 2D, GIF del esquemático y paquete de fabricación
2026-10-30 F9: pedido pasa a JLCPCB (D20). K1 = AQY214EHAX (NA, en stock en JLC), 11 lineas genericas a piezas Basic, BOM_JLC.csv y CPL_JLC.csv (paquete_jlc_f9.py), GUIA_PEDIDO_JLC.md, parametros de Altium (bom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
    [02_ALIMENTACION.SchDoc, 03_MEDICION.SchDoc, 04_MCU.SchDoc, 05_SENSORES.SchDoc, 06_ACTUACION.SchDoc, BOM_JLC.csv, BOM_PCBWay.xlsx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]
